youngskylty/SensoSpoon/EXPLANATION/08_GENERATED_OUTPUTS.md

# Generated Outputs (`output/`, `assets/geometry/`)

Everything in this document is **regenerated by scripts** — none of it is source content you'd hand-edit. Everything here was inferred from reading the scripts that produce each file; I did not visually inspect the images/videos themselves (I can't view rendered pixel content directly in this pass), so descriptions are of *what the generating code computes and draws*, not a frame-by-frame visual description.

## `output/figures/` — images and videos

| File | Produced by | What it shows |
|---|---|---|
| `rcflex_assembled.png` | `preview_rcflex_design('assembled')` | Full 3D assembly, all parts opaque: outer shell, spherical bezel, control panel, everything visible as the product would look externally. |
| `rcflex_cutaway.png` | `preview_rcflex_design('cutaway')` | Same assembly with the outer shell, bezel, moving carrier's outer surface, control panel, and buttons/LEDs hidden — revealing the internal flexures, actuators, pushrods, and PCB/battery. |
| `spoon_curved_neck_closeup.png` | `preview_spoon_closeup.m` | A tight camera crop on just the bowl, neck, spherical carrier, and quick-release collar. |
| `spoon_dimension_verification.png` | `preview_spoon_dimensions.m` | A 2D dimensioned-drawing-style figure (top view, longitudinal section, cross-section) with dimension lines confirming the 62×40×12 mm bowl and wall-thickness values against the analytic outline function. |
| `rcflex_voltage_response.png` | `plot_rcflex_plant.m`, called from `run_rcflex_analytic('voltage',...)` | 6-panel plot of an open-loop voltage test: applied voltage, solved current, solved joint angle, actuator displacement, force, copper loss, over the default common/differential voltage step sequence. |
| `voltage_test.mp4` | `animate_rcflex_analytic(S, ..., 'assembled')`, called from `START_PROJECT('simulate')` / `START_PROJECT('all')` | 3D animation of the assembled spoon responding to the same open-loop voltage step sequence — pure electromechanical response, no control algorithm. |
| `rcflex_physical_test.png` | Final frame export from `animate_rcflex_analytic.m` when `S.mode` is not `'closed_loop'` | A single still frame from the voltage-test animation. |
| `control_response.png` | `plot_rcflex_control.m` | 6-panel closed-loop response plot for one run: pitch/roll error vs. locked-baseline error, coil currents (with current-limit reference lines), actuator stroke (with stroke-limit lines), bowl position error, and copper loss (with continuous-power reference line). Title includes attitude RMS, suppression %, and position RMS for that run. |
| `control_demo.mp4` | `animate_rcflex_analytic(S,...,'assembled')`, called from `START_PROJECT('control')` | 3D animation of the assembled spoon under closed-loop control, for a native-Simulink control run. |
| `rcflex_control_animation.png` | Final-frame export from `animate_rcflex_analytic.m` when `S.mode == 'closed_loop'` | A still frame from the closed-loop control animation. |
| `control_comparison.mp4` / `.png` | `animate_rcflex_comparison.m`, called from `START_PROJECT('compare')` | Side-by-side "without compensation" (gimbal rigidly locked) vs. "with compensation" (closed-loop controlled) 3D animation, driven by identical base motion, with live pitch/roll error traces underneath. Two playback passes: real-time then quarter-speed. |
| `control_intent_response.png` | Referenced in project structure but not directly traced to a specific generating call in the read source files; based on naming and the "intent" scenario in `rcflex_control_case.m`, likely a response plot for an intent-tracking test case (case 10 in the benchmark set) — treat this description as inferred from naming, not directly confirmed against a specific script call. |
| `soup_5ml_comparison.mp4` / `.png` | `run_rcflex_soup_demo(5)` → `animate_rcflex_comparison(S, filename, F)` | Side-by-side comparison animation with an overlaid liquid surface: 5 mL soup, 8 Hz, 1°/axis tremor, uncompensated (locked) vs. compensated bowl, showing computed liquid slosh/level with neither side losing measurable liquid. |
| `soup_8ml_comparison.mp4` / `.png` | `run_rcflex_soup_demo(8)` | Same as above but 8 mL fill (near-full bowl capacity, ~9.1 mL) — the uncompensated side shows a very small computed spill (~0.0016 mL), compensated side shows none. |
| `soup_strong_tremor_comparison.mp4` / `.png` | `run_rcflex_strong_soup.m` | A more aggressive 4-second, 4 Hz, 5°/axis, 8 mL scenario — uncompensated side loses roughly a third of its liquid (~2.7 mL, ~34%) while the compensated side loses none computed. Plays first at real-time, then quarter-speed. |
| `tremor_hardware_envelope.png` | `evaluate_rcflex_envelope.m` | Two-panel figure: required peak current vs. tremor frequency (for two payload levels) compared against the actuator's current limit, assuming *ideal* attitude tracking (inverse-dynamics feasibility, not an actual controller run); and a bar chart comparing bowl position RMS for a locked spoon vs. ideal attitude tracking, illustrating that leveling the bowl doesn't stop it translating. |

## `output/results/` — data and reports

| File | Produced by | Content |
|---|---|---|
| `analytic_validation.txt` | `test_rcflex_physics.m` | A JSON-formatted record of the physics test's measured tolerances: rod closure error, Jacobian error, energy-balance error, solver-convergence difference, max transmission-Jacobian condition number, max direct-rod side load — from the last time the test ran. |
| `analytic_hardware_validation.csv` | `test_rcflex_hardware.m` | A one-row table: locked-rotor RL step error, reversed-polarity error, and payload-response-difference magnitude from the last hardware acceptance test run. |
| `validation_summary.csv` | `run_validation.m` | Pass/fail and elapsed time for all eleven checks in the validation suite (see `07_TESTS.md`). |
| `control_training.csv` | `tune_rcflex_control.m` | Small grid-search results (lowpass filter cutoff × attitude bandwidth) against per-frequency tremor RMS and an intent-tracking error — an early design-exploration record, not the final selected design (which uses the notch filter instead). |
| `control_benchmark.csv` | `benchmark_rcflex_control.m` | The 20-scenario held-out benchmark table: per-case scenario name, frequency, amplitude, payload, bus voltage, and every metric from `rcflex_control_metrics.m` (attitude RMS, suppression %, position RMS, currents, stroke, power, side load, whether it stayed within hardware limits). |
| `control_case_01.mat` … `control_case_20.mat` | `benchmark_rcflex_control.m` | Full saved simulation result (`S`) and metrics (`m`) for each of the 20 benchmark cases individually. |
| `control_numerical_verification.csv` / `.mat` | `verify_rcflex_control_numerics.m` | Cross-check of the fast multirate control integrator against native Simulink at three mechanical step sizes — joint-angle RMS/peak differences and suppression-percentage differences. |
| `control_native.mat` | `run_rcflex_control.m` (default call) | The saved native-Simulink closed-loop reference run (8 Hz, 1°/axis, default 5 g payload) used as the authoritative reference elsewhere (e.g. by `verify_rcflex_control_numerics.m` and `write_rcflex_control_report.m`). |
| `control_initial.mat` | Likely an earlier/first native control run snapshot (naming suggests a first-pass saved result; not directly traced to a currently-active call in the read scripts). |
| `CONTROL_RESULTS.md` | `write_rcflex_control_report.m` | Human-readable markdown report: the 20-case benchmark table, notes on what each special case tests, the fast-vs-native cross-check numbers, and the native-reference headline numbers. This is the single most important results document for judging current controller performance — see `03_CONTROL_SYSTEM.md` for the numbers themselves. |
| `liquid_5ml.mat`, `liquid_near_full.mat`, `liquid_comparison.mat` | `run_rcflex_soup_demo.m` / `simulate_rcflex_liquid.m` (`saveResult=true` path) | Saved fluid-simulation structs (`F`) for specific fill volumes, paired with the mechanical result `S` they were computed from. |
| `liquid_refinement.csv` | Referenced in `docs/LIQUID_MODEL.md` as the grid/step-refinement sensitivity check for the 8 mL case (halved grid spacing and time step). |
| `strong_soup_native.mat` | `run_rcflex_strong_soup.m` | Saved mechanical (`S`), fluid (`F`), and metrics (`m`) for the 4 Hz/5°/8 mL strong-tremor scenario. |
| `strong_soup_refinement.mat` / `.csv` | `run_rcflex_strong_soup.m` | A refined-grid re-run of the strong-tremor fluid case (half grid spacing, half time step) compared against the original, for both "without spill tracking" and "with spill tracking" totals. |
| `strong_soup_screen.csv`, `strong_soup_screen_3deg.mat` / `_4deg.mat` / `_5deg.mat` | `screen_rcflex_strong_soup.m` | A fast-integrator screening sweep over 3/4/5° amplitude at the strong-tremor scenario, checking hardware limits and computing spill before committing to the (slower) native-Simulink strong case. |
| `tremor_hardware_envelope.csv` | `evaluate_rcflex_envelope.m` | The full feasibility table behind the `tremor_hardware_envelope.png` figure — one row per payload/frequency/amplitude combination, with required current/voltage/power/side-load/stroke and a `nominal_feasible` flag. |
| `tremor_robustness.csv` | `evaluate_rcflex_robustness.m` | The same envelope table computed twice — once nominal, once with several hardware parameters deliberately worsened — concatenated with a `scenario` column. |
| `notch_frequency_trial.csv` | Naming suggests an exploratory trial of notch-filter frequency placement (part of arriving at the final 4/6/8/10/12 Hz notch design); not directly traced to an active generating call among the read scripts — likely from an earlier tuning pass. |
| `cleanup_baseline.mat`, `cleanup_regression.txt`, `analysis_run.txt` | Records from the project reorganization described in `docs/CLEANUP.md` — a saved pre-cleanup baseline and a regression-comparison log confirming the reorganized code reproduces identical results; not something you need to regenerate or rely on for ongoing work. |

## `assets/geometry/` — 3D geometry

- **`assembly.mat`** — the master saved data: the full parts struct array `A` (name, body, category, color, mass, mesh vertices/faces, STL filename) plus the hardware parameter struct `H` used to generate it. Nearly everything downstream that needs 3D geometry (animators, previews, body-property calculations, the liquid-geometry bowl profile) loads this one file rather than regenerating meshes each time.
- **`parts_manifest.csv`** — a flat table of every part's name, rigid body group, category, and mass in grams — a quick way to see the full parts list and their masses without loading the `.mat` file.
- **One `.stl` file per part** (e.g. `Spoon_bowl.stl`, `VCA_A_winding.stl`, `Cflex_B10_fixed_1.stl`, etc.) — standard binary STL triangle meshes, in metres, one per named part in the assembly, generated by the hand-written `write_stl` helper inside `generate_rcflex_assets.m`. These could in principle be opened in any CAD viewer to inspect the geometry directly.

All of the above regenerate automatically: `START_PROJECT` rebuilds `assembly.mat` (and thus every STL) whenever the current `rcflex_parameters()` struct doesn't match the one cached inside the existing `assembly.mat` — you do not need to run the geometry generator by hand unless you're calling its lower-level functions directly.
