youngskylty/SensoSpoon/EXPLANATION/SensoSpoon Simulation Architecture.png

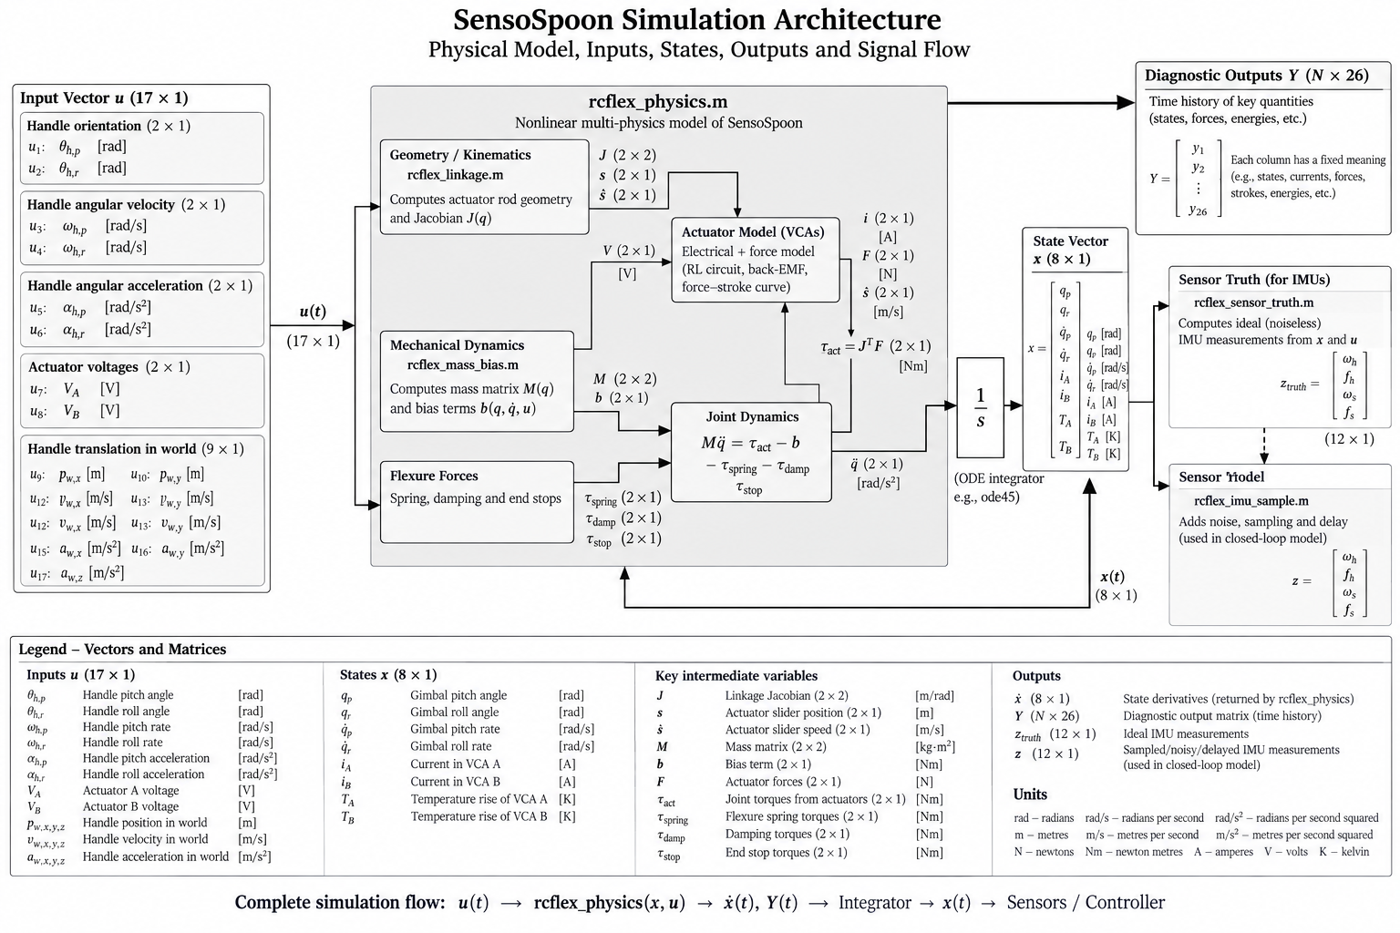
EXPLANATION/SensoSpoon Simulation Architecture.png
