youngskylty/SensoSpoon/output/figures/bench_attitude_error.png

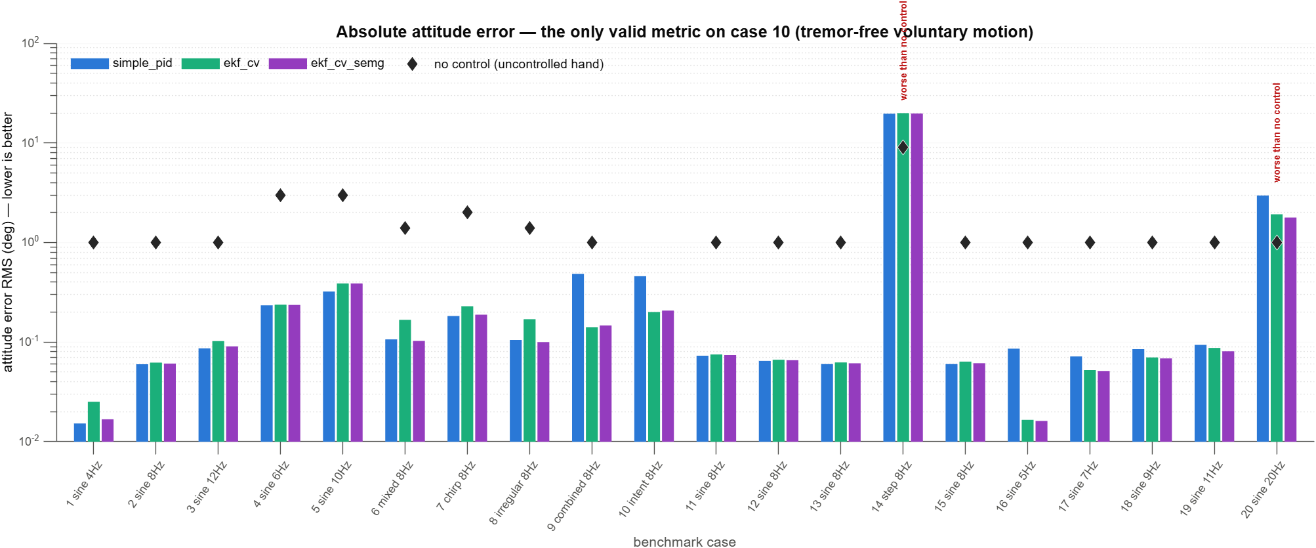
output/figures/bench_attitude_error.png
