youngskylty/SensoSpoon/output/figures/bench_delta_vs_baseline.png

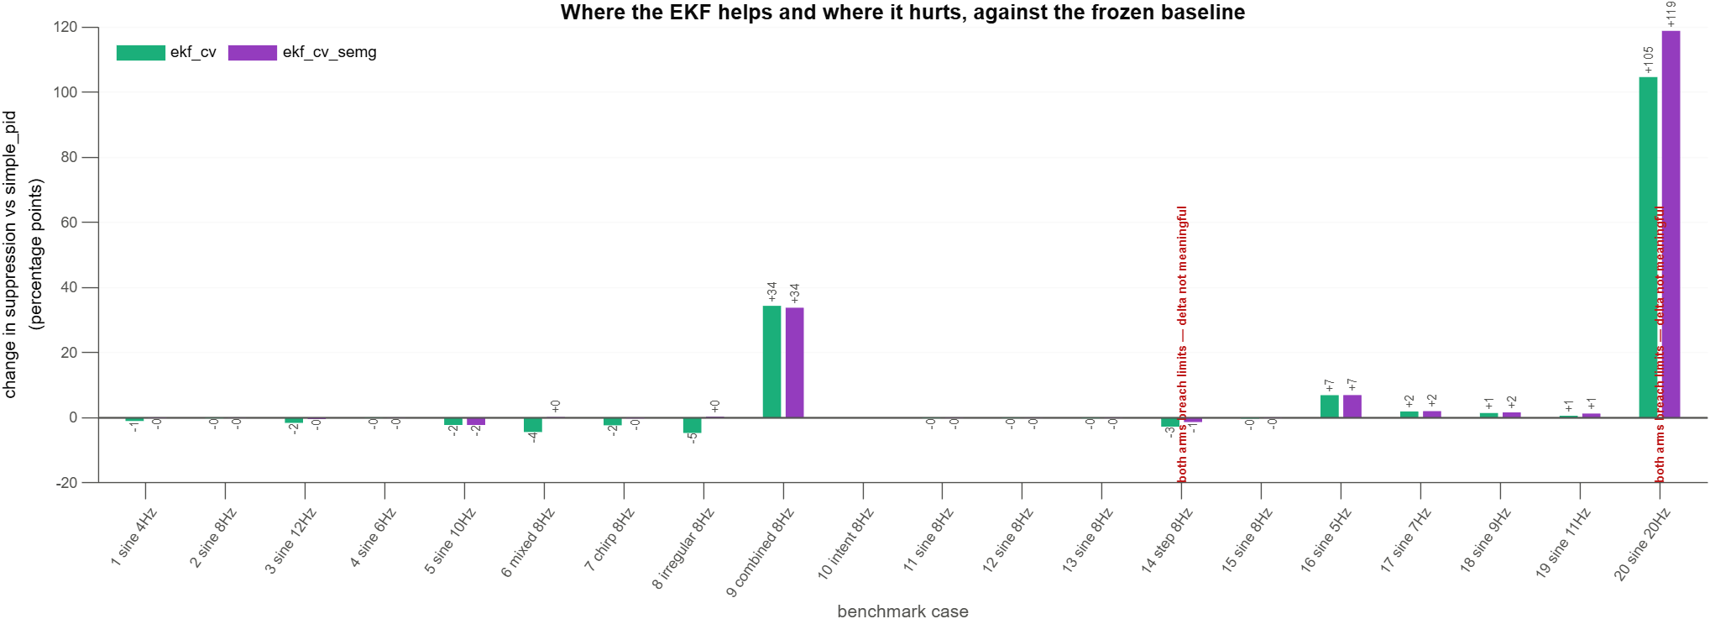
output/figures/bench_delta_vs_baseline.png
