youngskylty/SensoSpoon/output/figures/bench_suppression.png

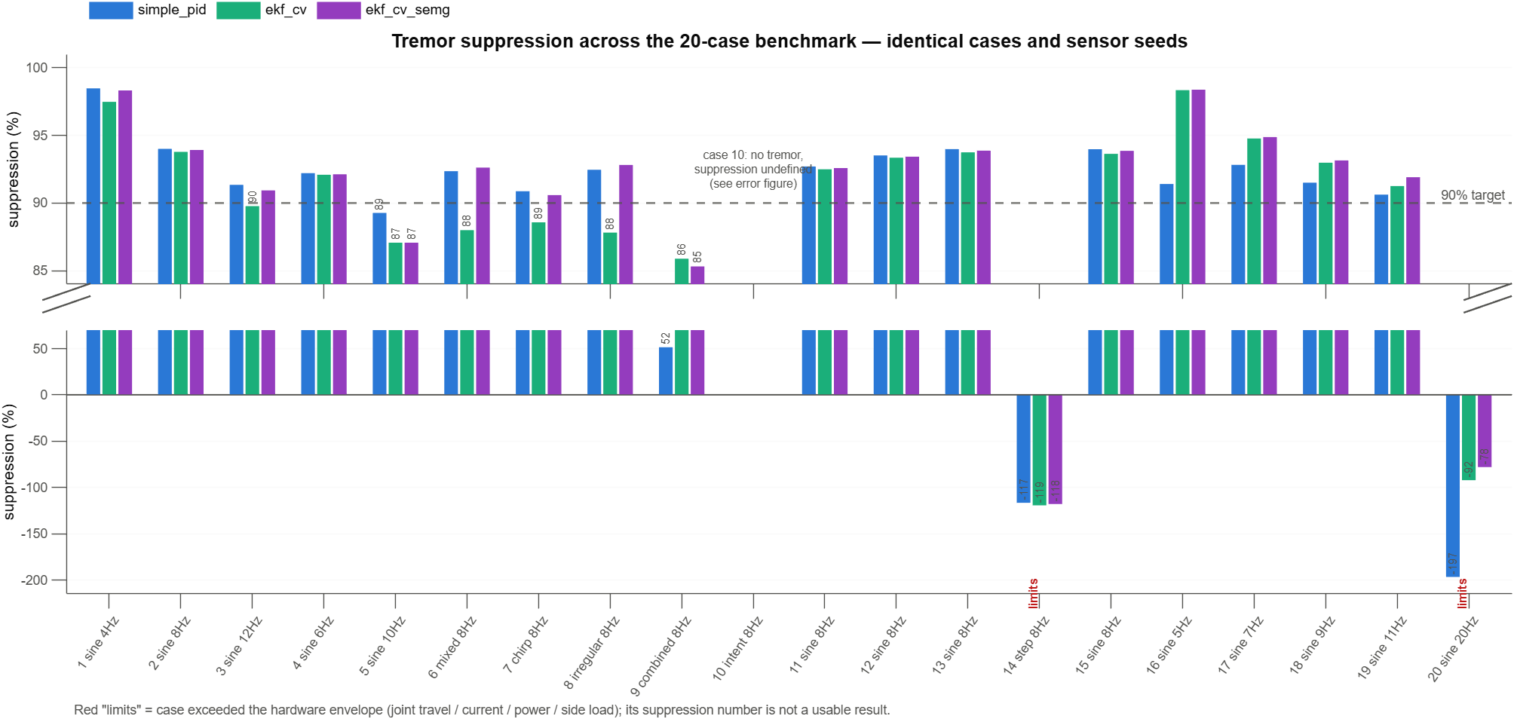
output/figures/bench_suppression.png
