youngskylty/SensoSpoon/output/figures/control_comparison.png

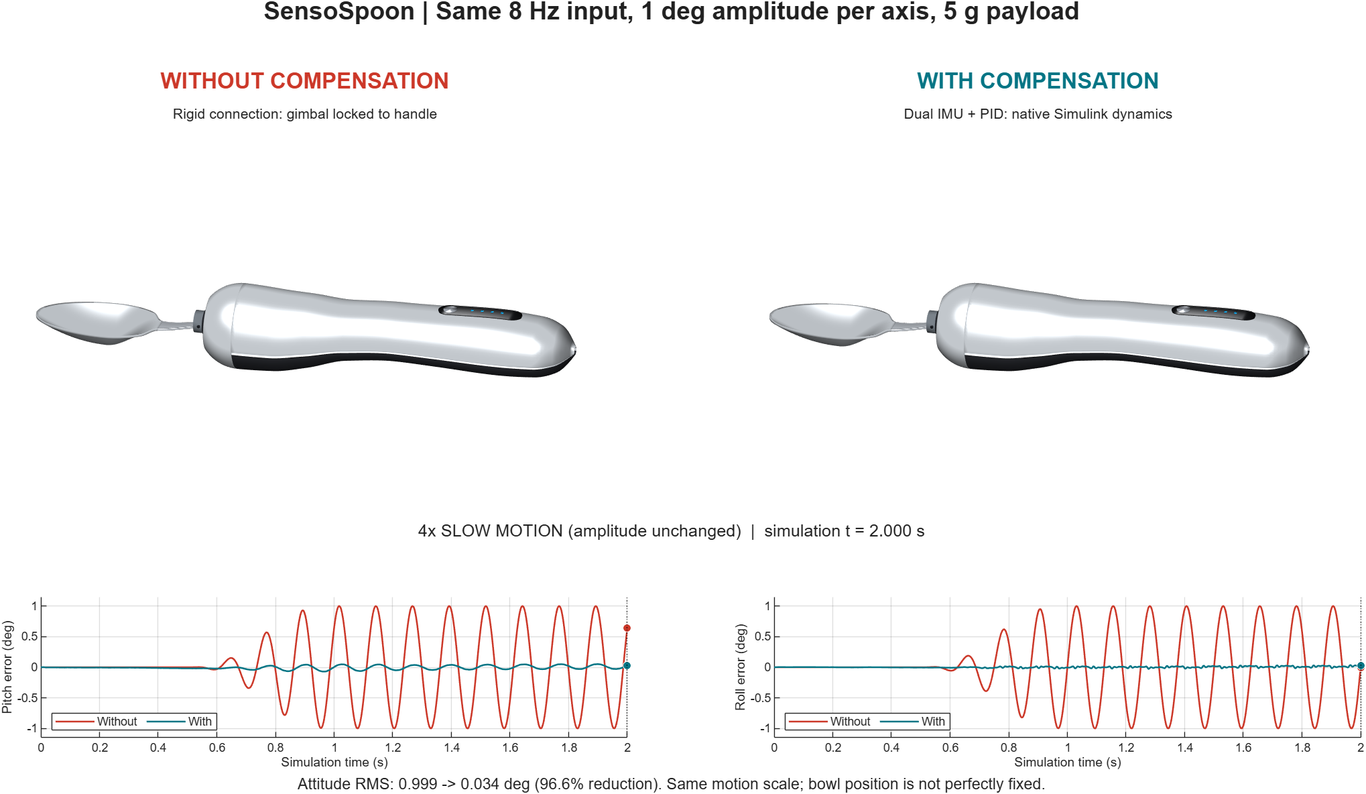
output/figures/control_comparison.png
