youngskylty/SensoSpoon/output/figures/control_intent_response.png

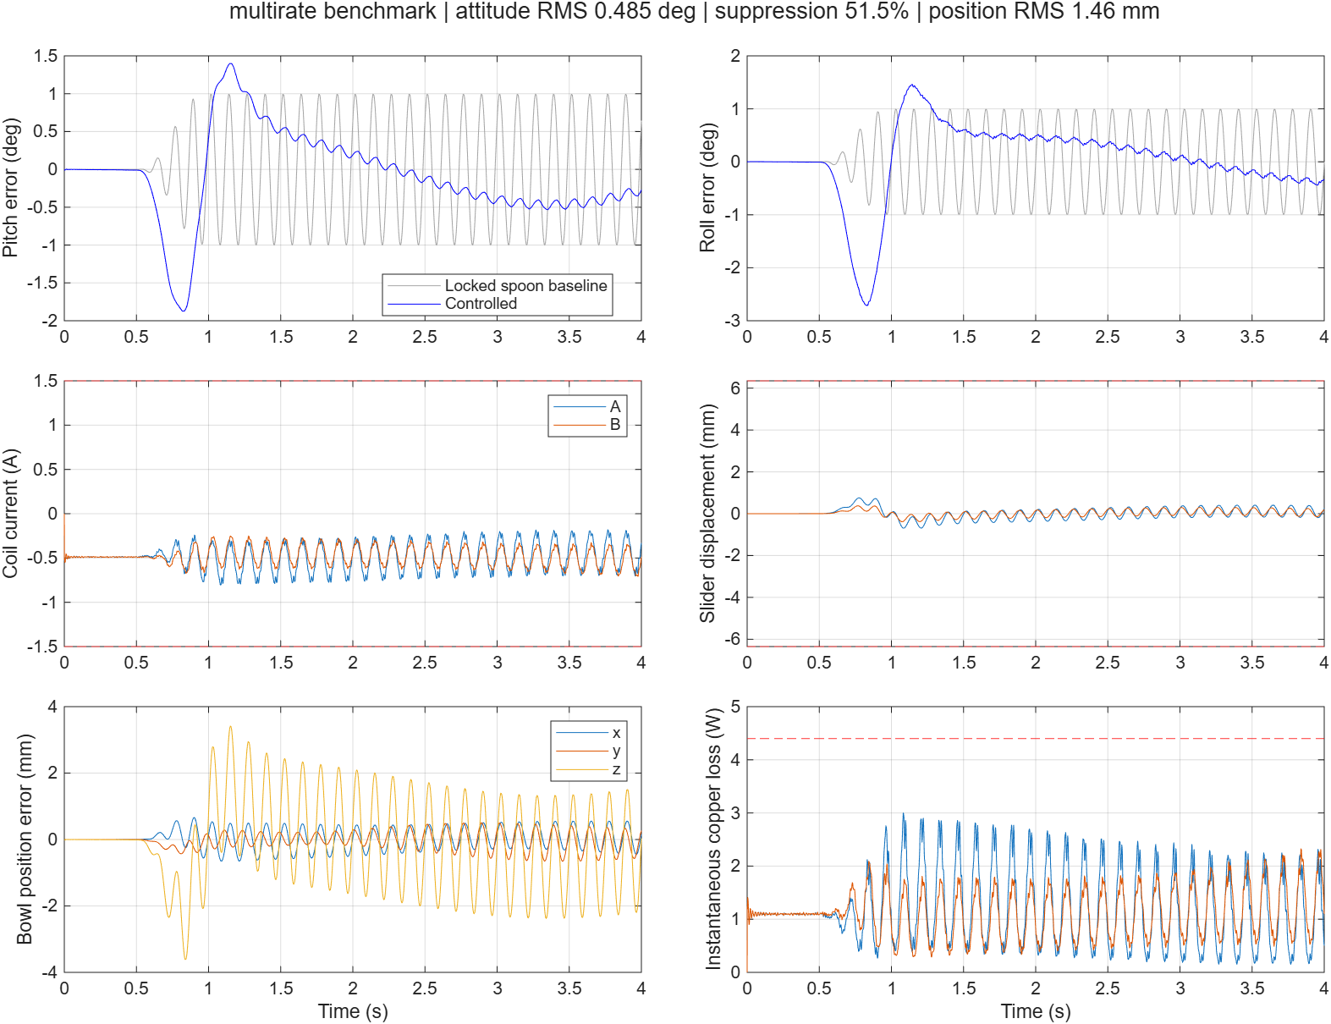
output/figures/control_intent_response.png
