youngskylty/SensoSpoon/output/figures/control_response.png

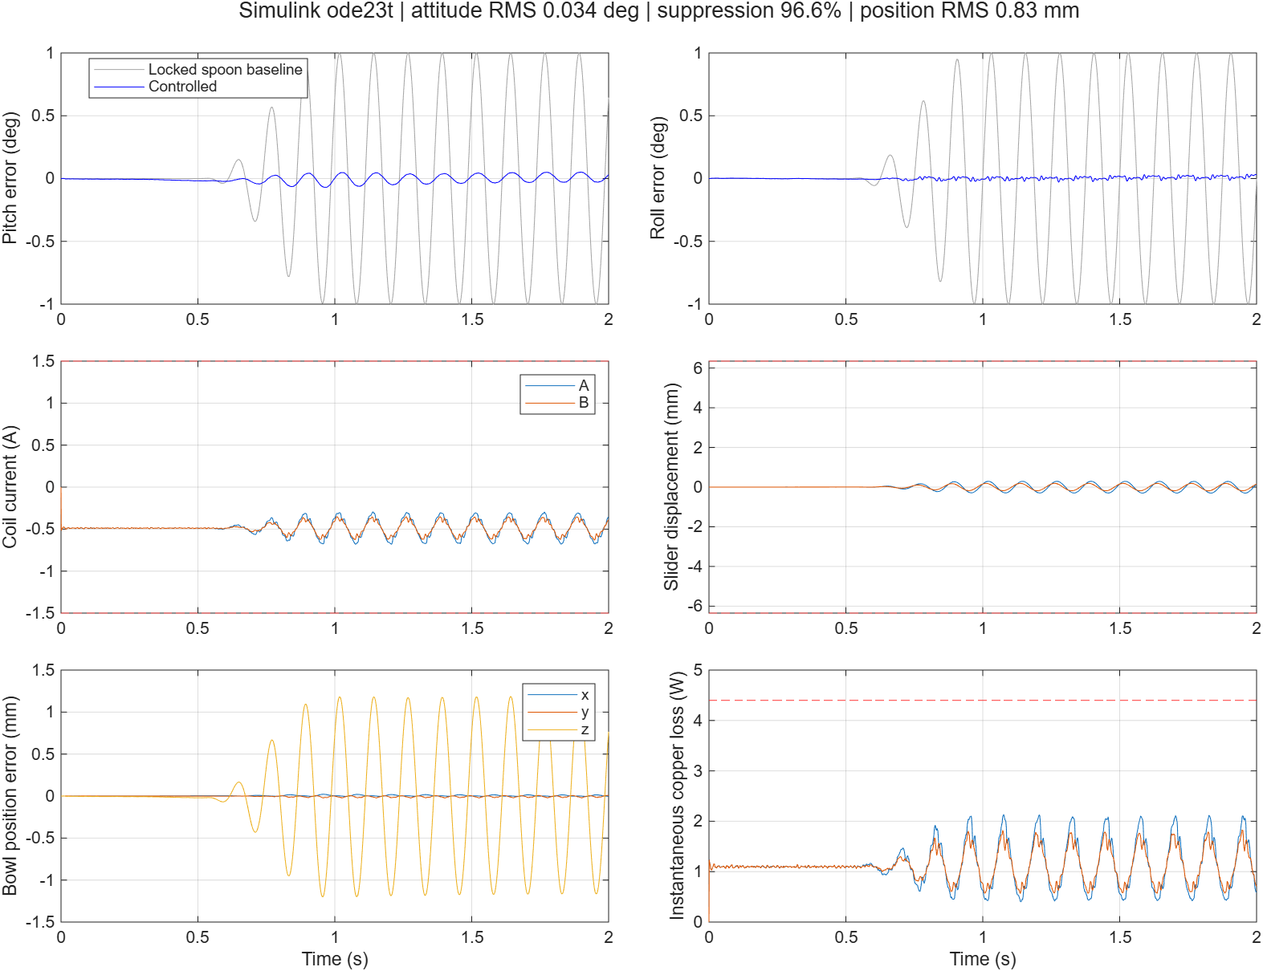
output/figures/control_response.png
