youngskylty/SensoSpoon/output/figures/fast_movement_detectors.png

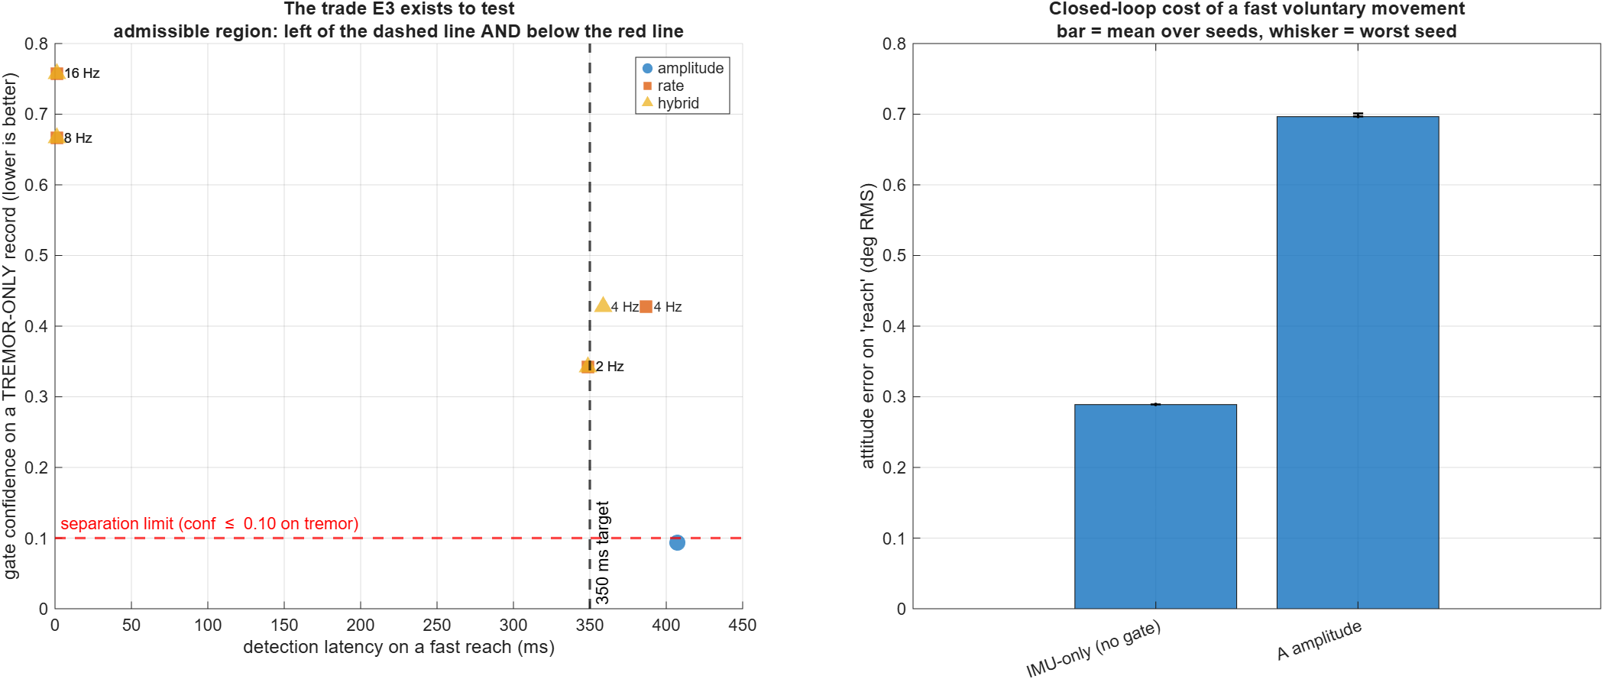
output/figures/fast_movement_detectors.png
