youngskylty/SensoSpoon/output/figures/intent_absorption_vs_frequency.png

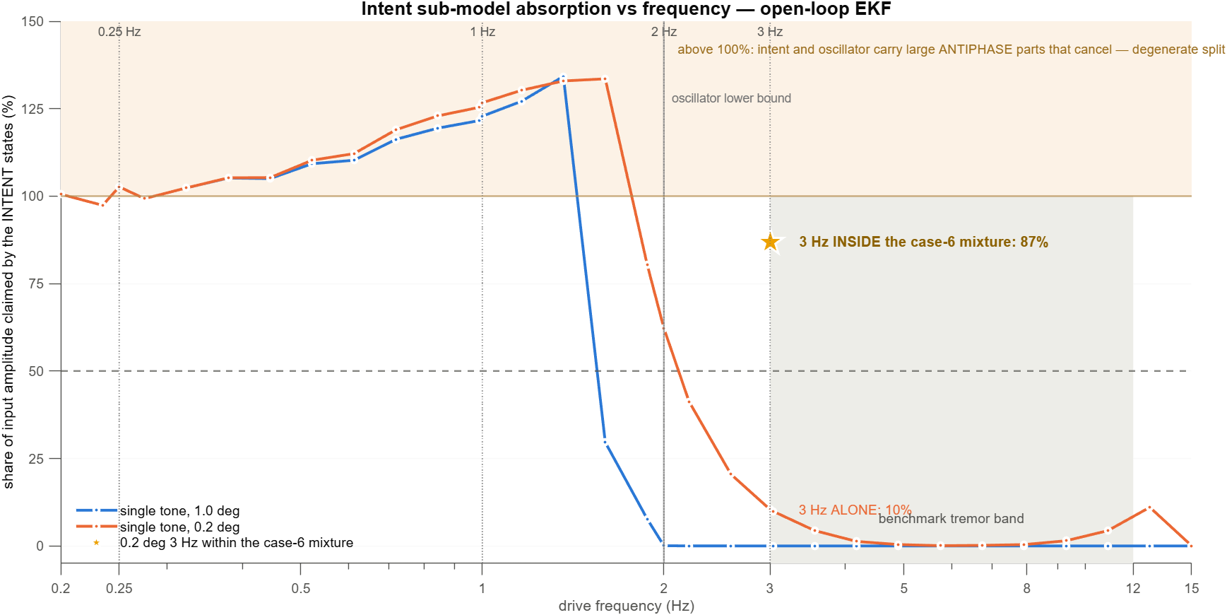
output/figures/intent_absorption_vs_frequency.png
