youngskylty/SensoSpoon/output/figures/intent_authority_ceiling.png

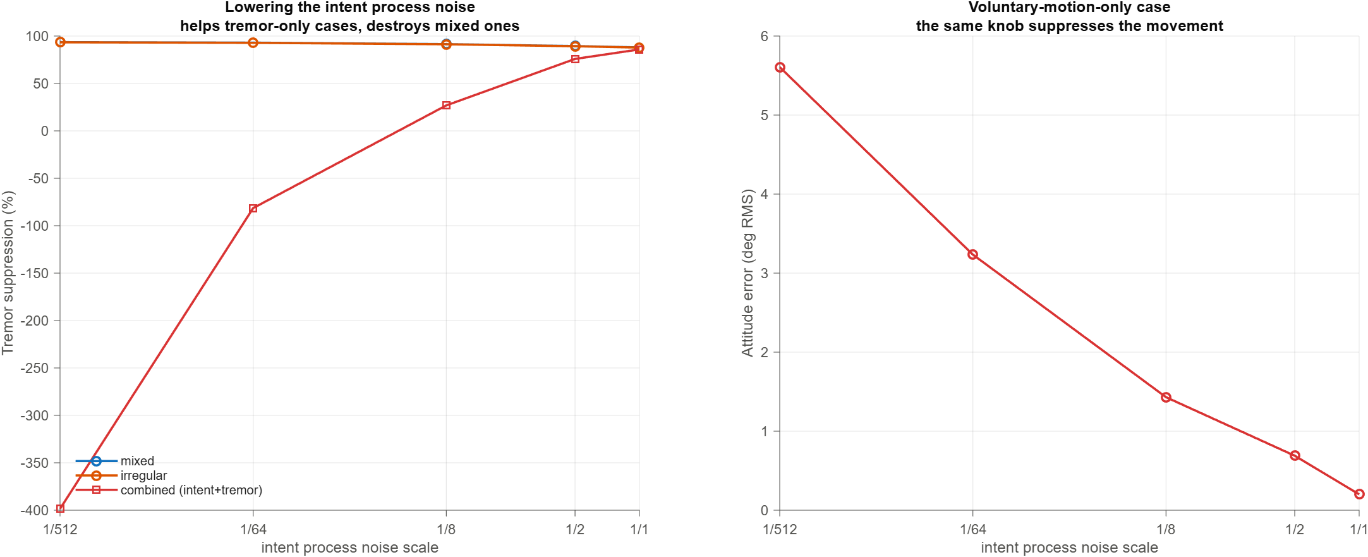
output/figures/intent_authority_ceiling.png
