youngskylty/SensoSpoon/output/figures/joint_travel_authority.png

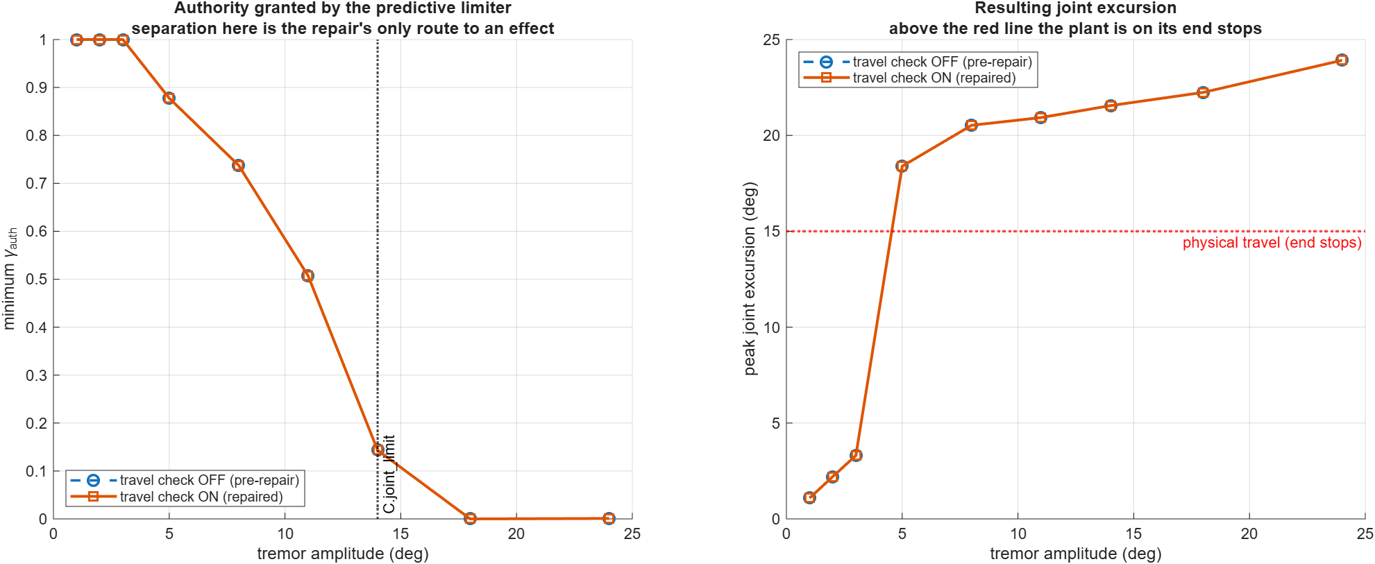
output/figures/joint_travel_authority.png
