youngskylty/SensoSpoon/output/figures/rcflex_control_animation.png

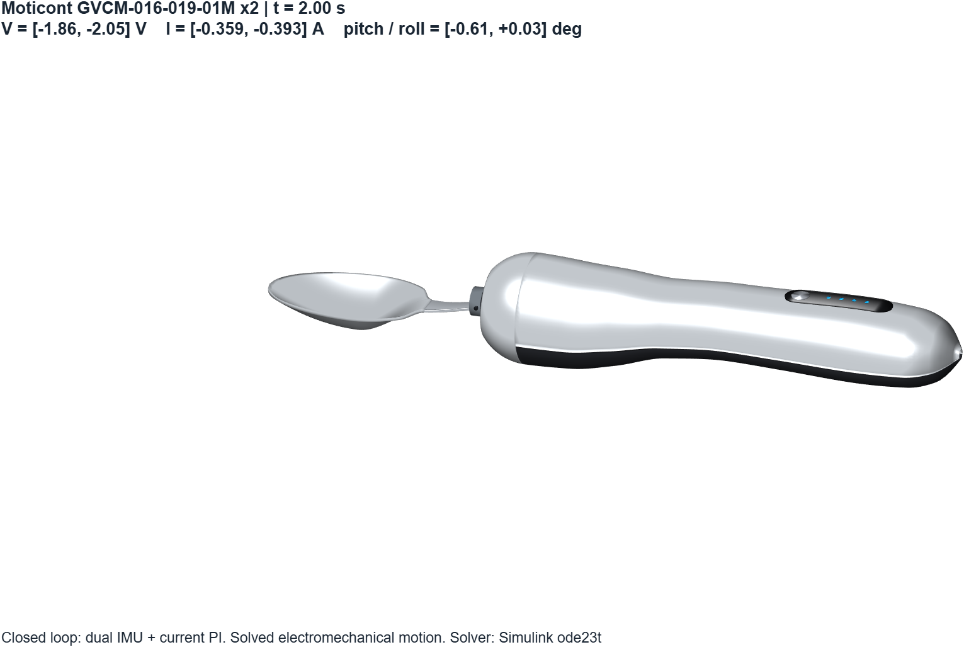
output/figures/rcflex_control_animation.png
