youngskylty/SensoSpoon/output/figures/rcflex_cutaway.png

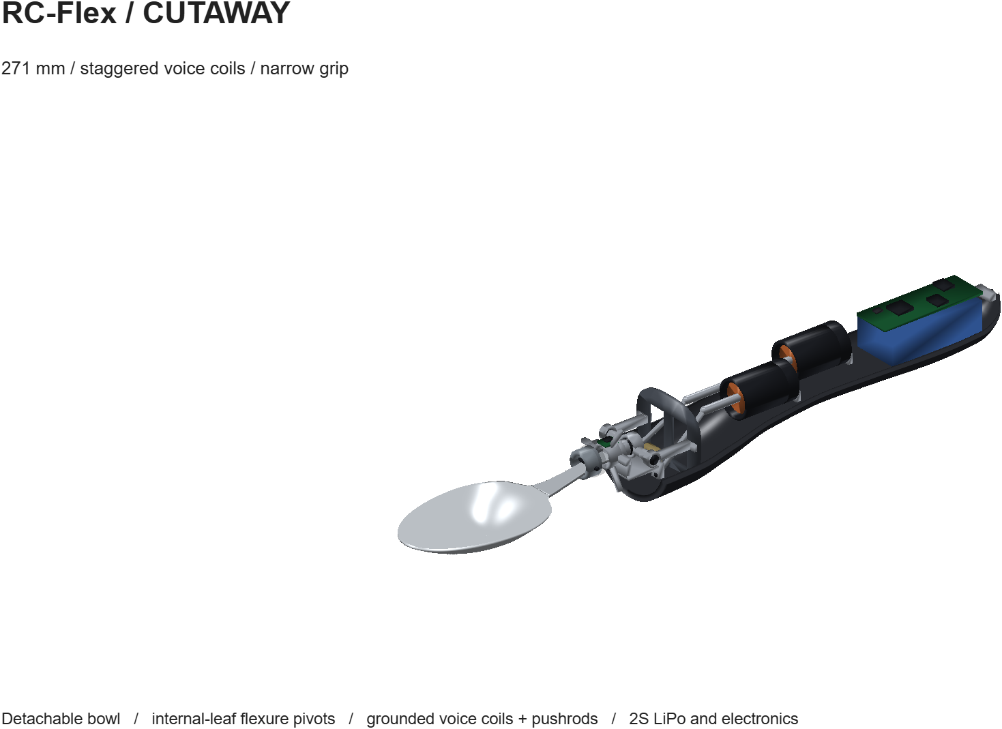
output/figures/rcflex_cutaway.png
