youngskylty/SensoSpoon/output/figures/rcflex_voltage_response.png

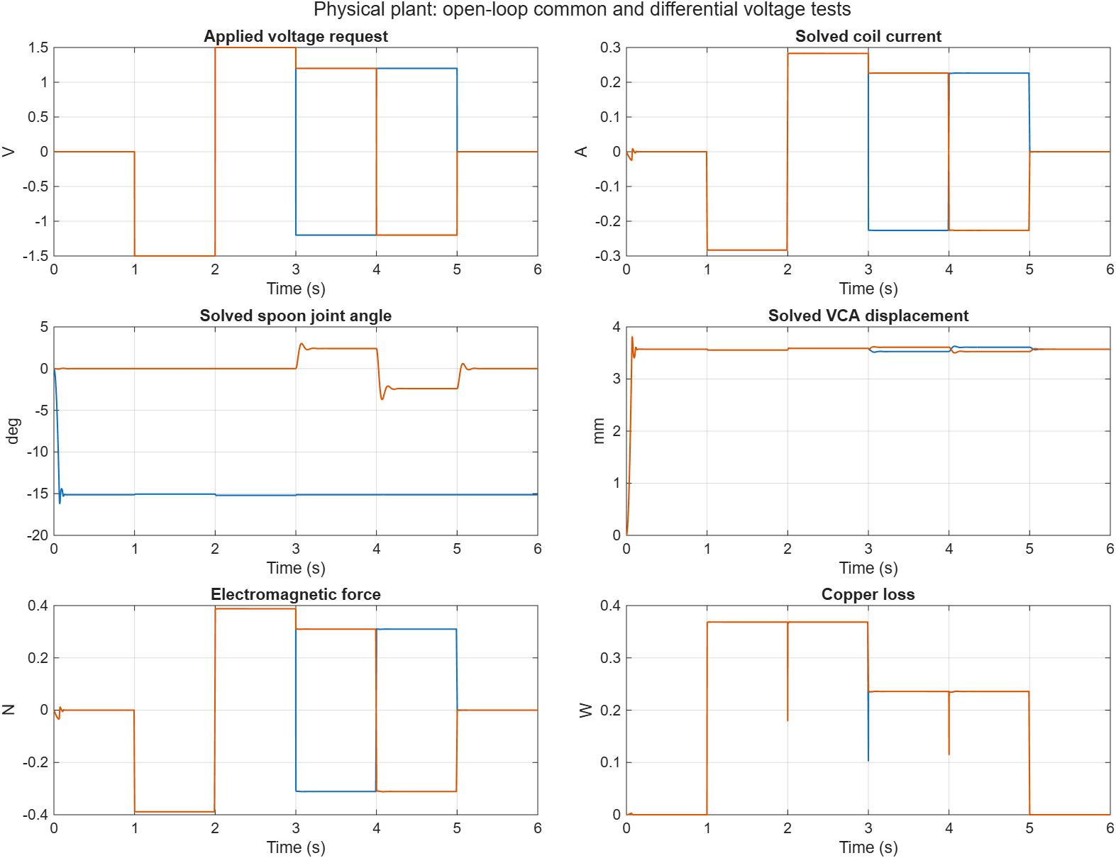
output/figures/rcflex_voltage_response.png
