youngskylty/SensoSpoon/output/figures/report/fig_reach_gate.png

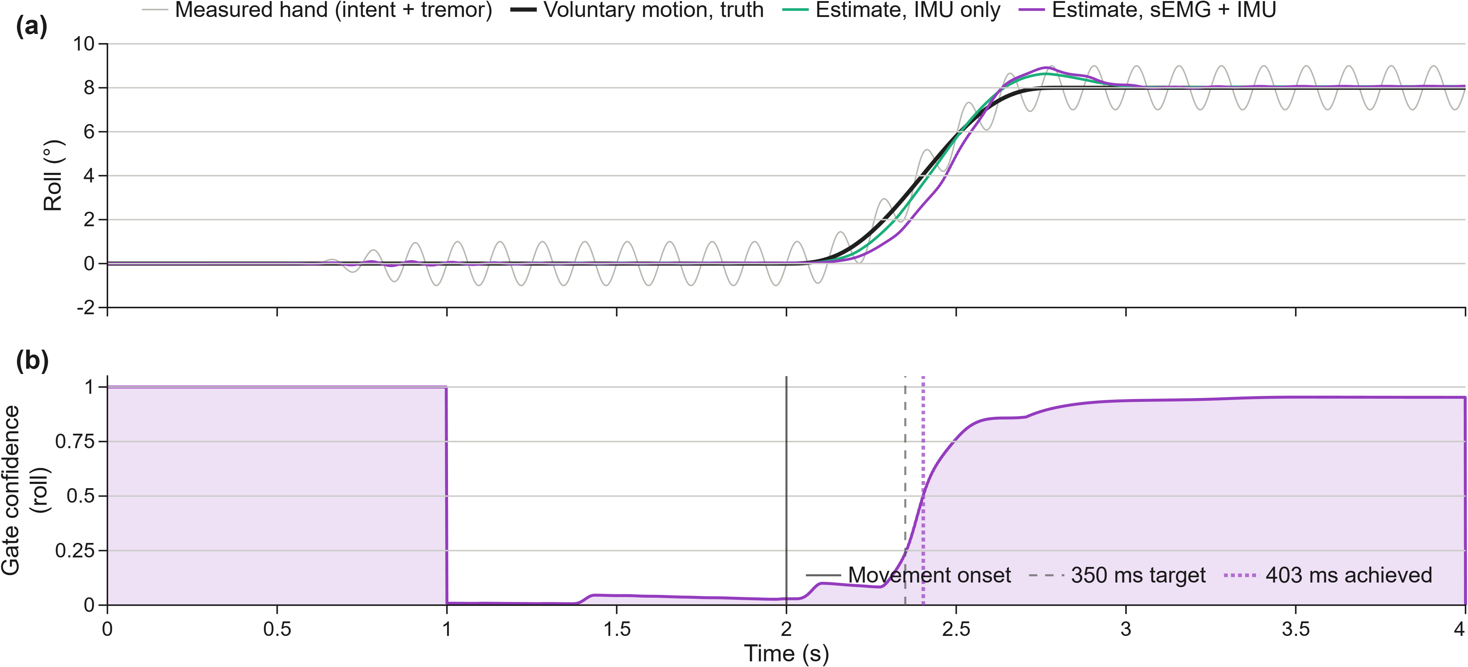
output/figures/report/fig_reach_gate.png
