youngskylty/SensoSpoon/output/figures/semg_gate_reach.png

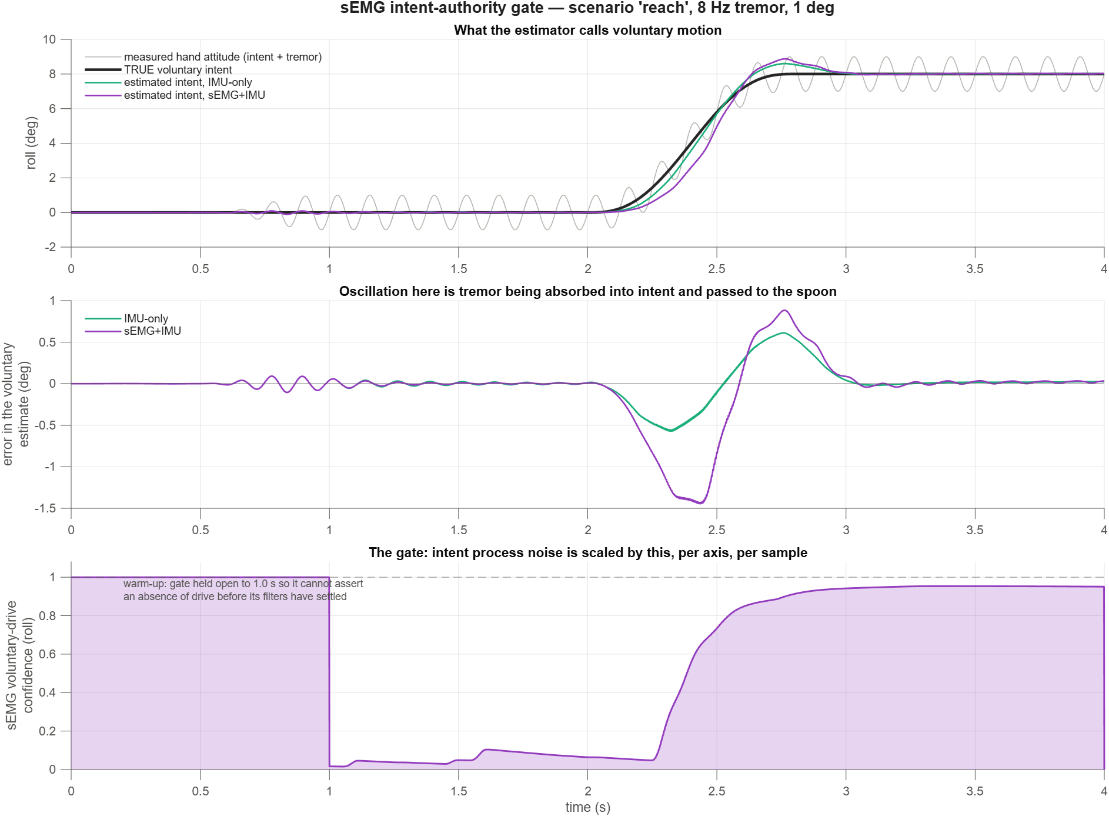
output/figures/semg_gate_reach.png
