youngskylty/SensoSpoon/output/figures/semg_intent_separation.png

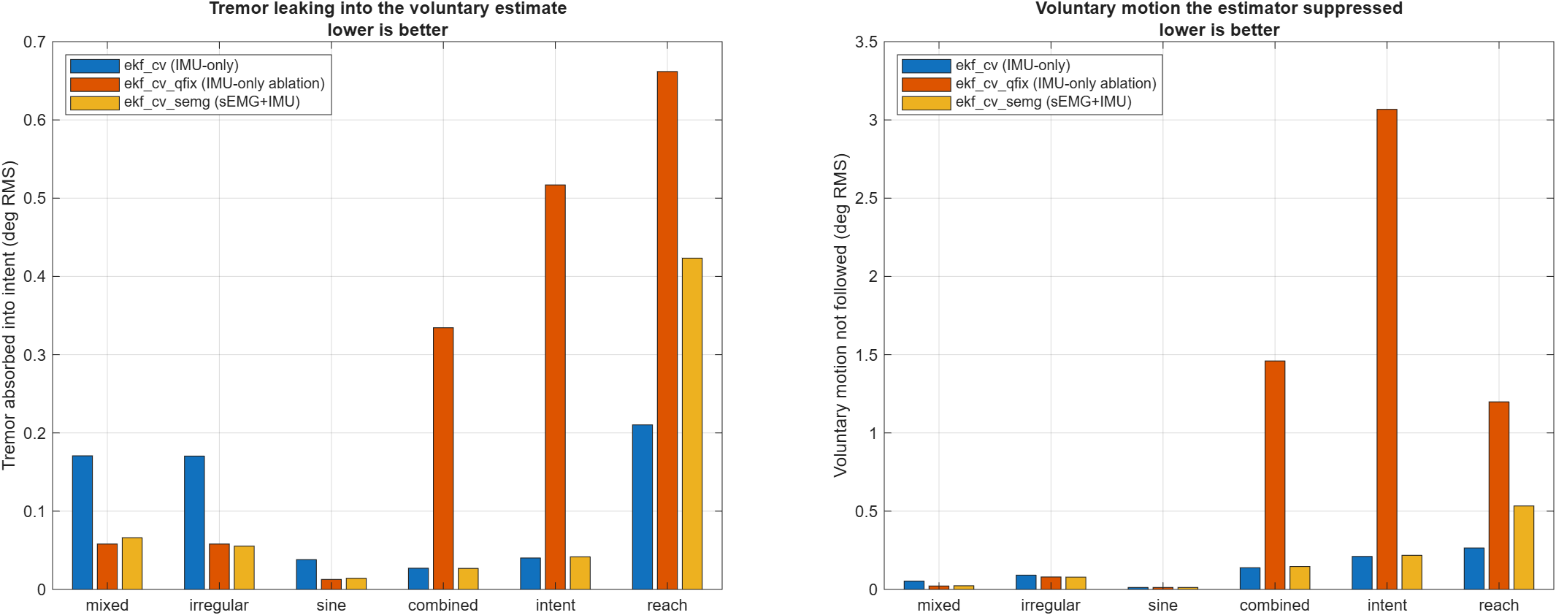
output/figures/semg_intent_separation.png
