youngskylty/SensoSpoon/output/figures/semg_separation_real.png

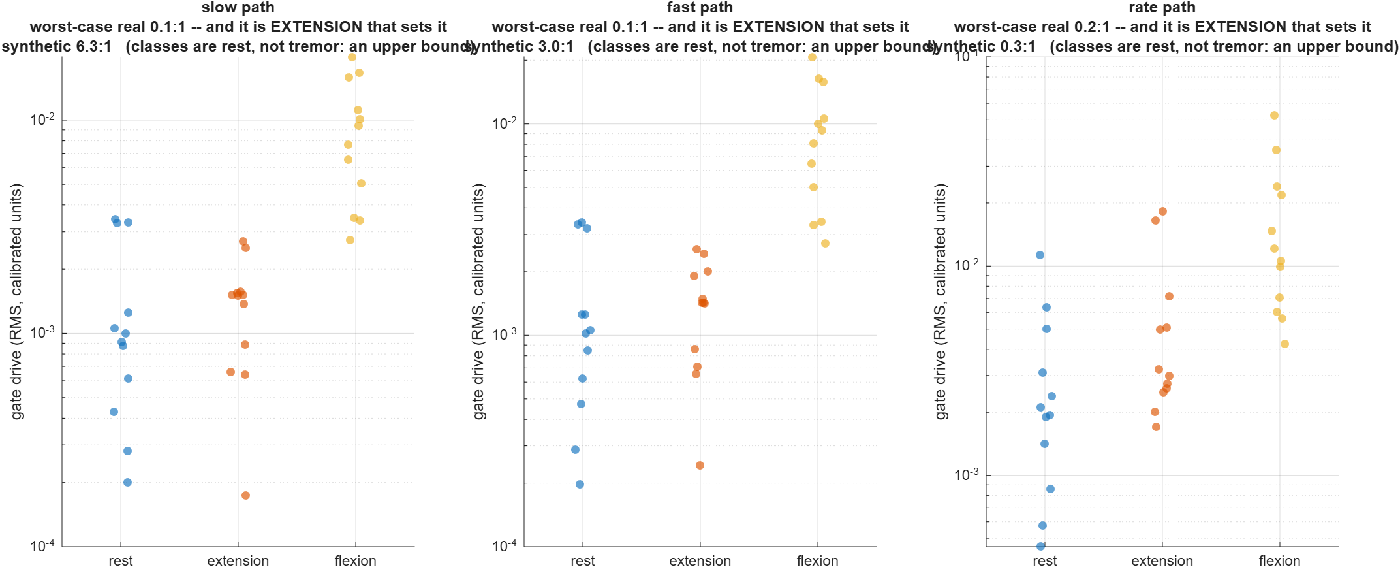
output/figures/semg_separation_real.png
