youngskylty/SensoSpoon/output/figures/soup_5ml_comparison.png

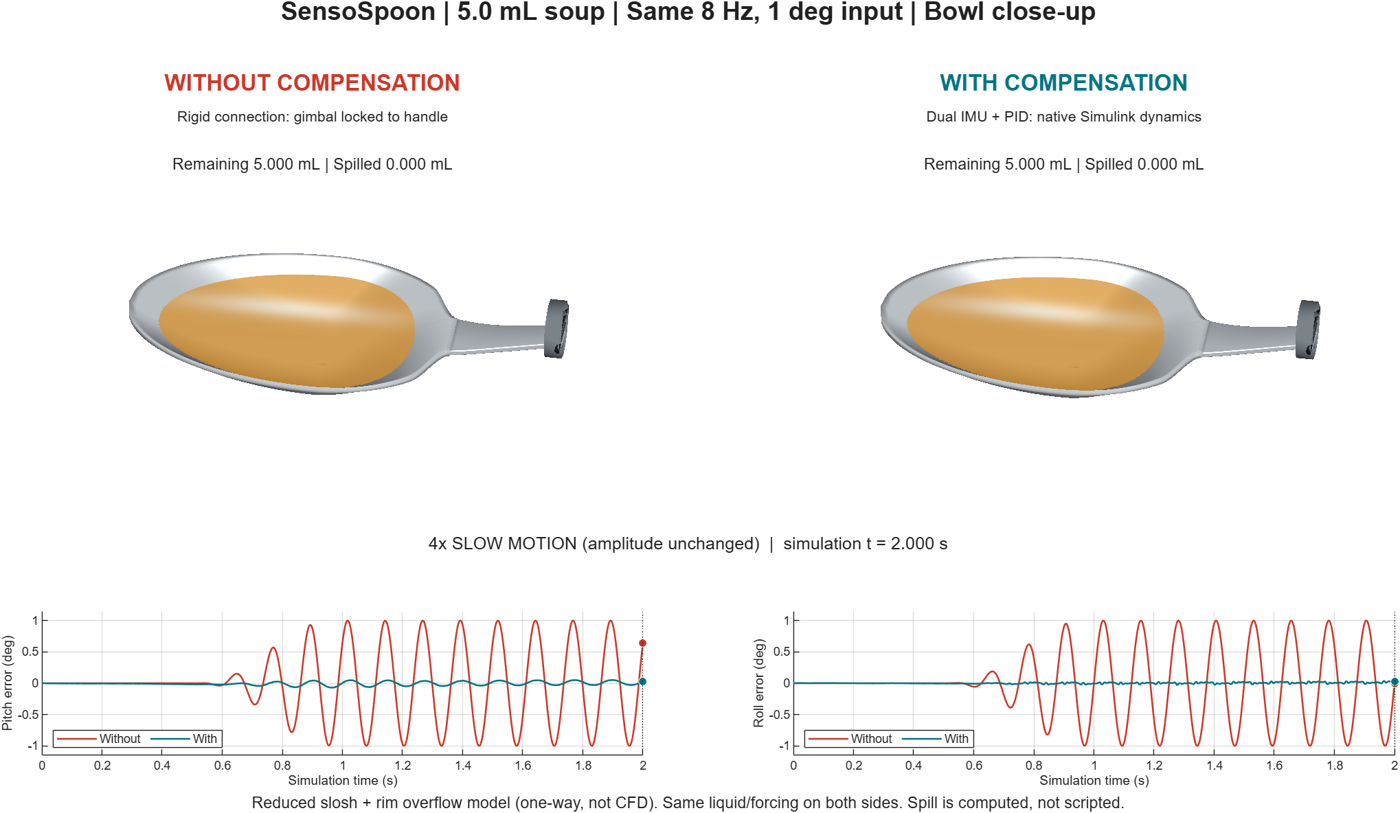
output/figures/soup_5ml_comparison.png
