youngskylty/SensoSpoon/output/figures/soup_strong_tremor_comparison.png

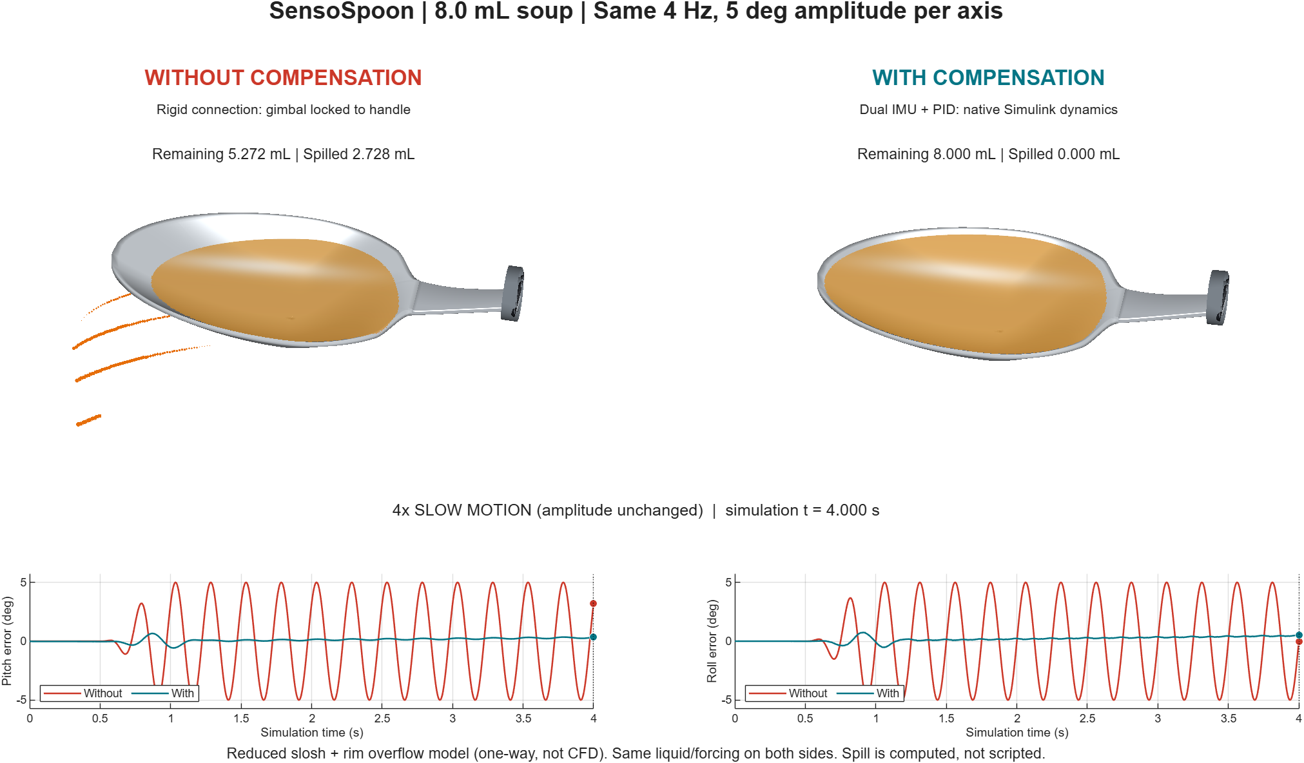
output/figures/soup_strong_tremor_comparison.png
