youngskylty/SensoSpoon/output/figures/spoon_curved_neck_closeup.png

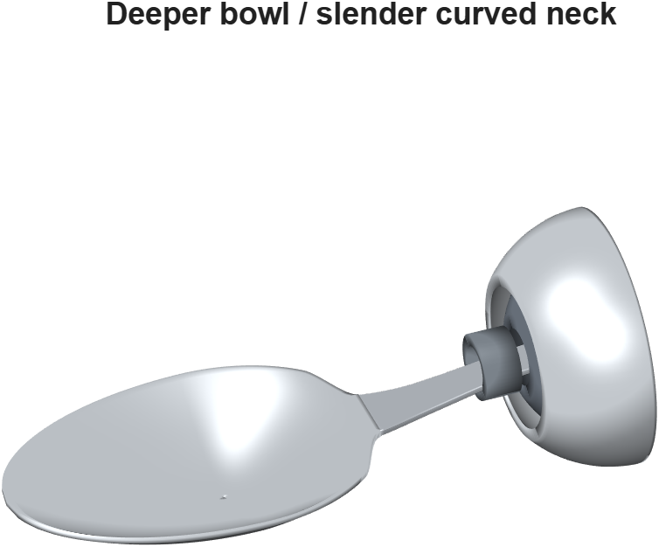
output/figures/spoon_curved_neck_closeup.png
