youngskylty/SensoSpoon/output/figures/tremor_hardware_envelope.png

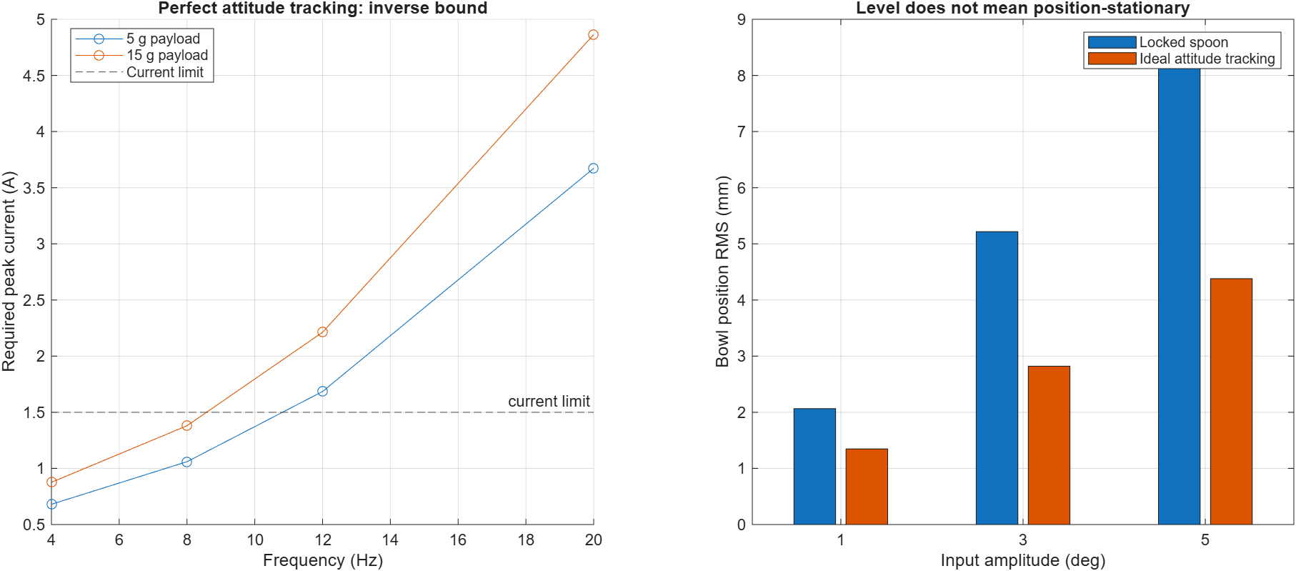
output/figures/tremor_hardware_envelope.png
