youngskylty/SensoSpoon/output/documents/SensoSpoon_Cost_and_Retail_Price_Analysis.docx

# SensoSpoon Cost and Retail Price Analysis

New Zealand market | 20 September 2026

Recommended launch price: NZ$699 including GST, with a regular price of NZ$799. The complete set includes the stabilising spoon, detachable spoon head, two-channel EMG cuff, charging accessories and carry case.

# Target production cost

The following targets assume approximately 1,000 units and production-ready components. They are planning estimates, not supplier quotations. All costs are NZD per set, excluding GST.

Item | Target cost
Two voice-coil actuators | $60
Gimbal, flexures, pushrods and connections | $35
Spoon electronics and assembled PCB | $40
Spoon battery, charging and protection | $15
Spoon head, housing and seals | $25
Complete two-channel EMG cuff | $60
Final assembly, calibration and testing | $35
Charging accessories, packaging and carry case | $12
Bulk freight and import handling allowance | $12
Total target landed cost | $294

Budget approximately NZ$300 per set delivered to a New Zealand warehouse. This requires lower-cost production sourcing; current industrial actuator and flexure prices are unconfirmed. Development, tooling and compliance testing are additional costs.

# Recommended retail prices

Package | Price including GST
Complete set - introductory price | NZ$699
Complete set - regular price | NZ$799
Spoon-only version - target price | NZ$549

A local benchmark is the Gyenno Bravo Twist, listed at NZ$790 including GST by MoveSmart and marked sold out when checked. Its accessories and functionality differ from SensoSpoon.

At NZ$699, revenue excluding 15% GST is approximately NZ$608. A NZ$300 landed cost leaves approximately NZ$308 gross profit per set (51%), before customer delivery, marketing, warranty, support and development expenses.

# Launch recommendation

Start with direct sales at NZ$699, subject to supplier quotes supporting a landed cost near NZ$300 and tests confirming useful EMG benefit. Keep a spoon-only option to lower the entry price. These prices remain targets until production costs and customer willingness to pay are validated.

Sources: MoveSmart product listing (https://movesmart.nz/products/gyenno-bravo-twist-spoon) | Inland Revenue GST guidance (https://www.ird.govt.nz/gst/charging-gst)
