youngskylty/SensoSpoon/assets/geometry/Coil_A_turn_09.stl

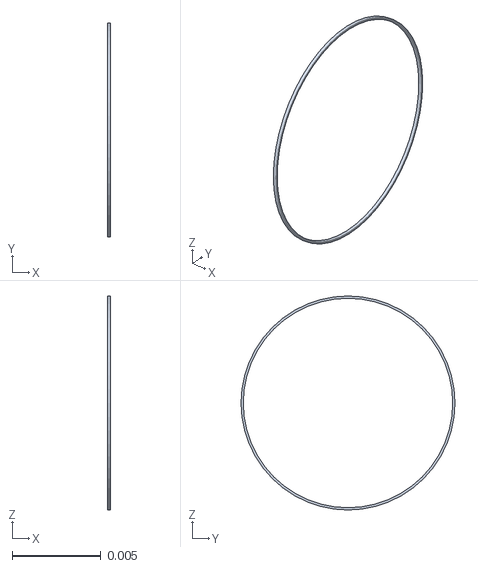
[picture p39: CAD file, 2026-09-11]
assets/geometry/Coil_A_turn_09.stl
0.00015 x 0.0121 x 0.0121
