youngskylty/SensoSpoon/assets/geometry/Roll_pivot_collet.stl

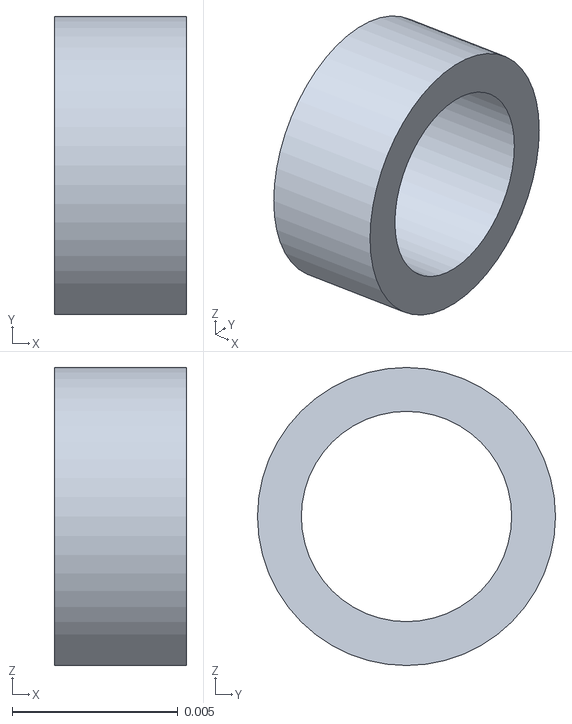
[picture p40: CAD file, 2026-09-11]
assets/geometry/Roll_pivot_collet.stl
0.004 x 0.009 x 0.009
