youngskylty/SensoSpoon/assets/geometry/Spoon_neck.stl

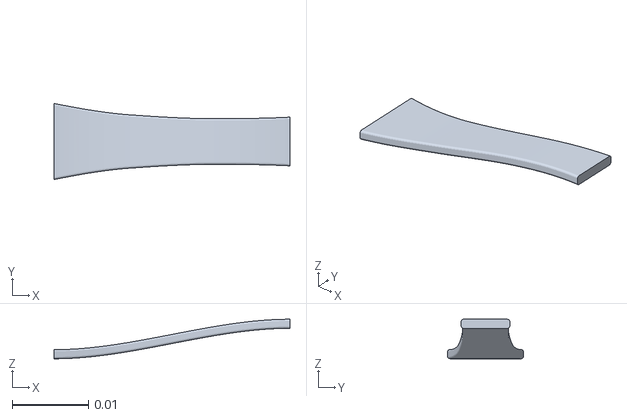
[picture p41: CAD file, 2026-09-11]
assets/geometry/Spoon_neck.stl
0.031 x 0.01 x 0.0052
