youngskylty/SensoSpoon/assets/geometry/Cheek_handle_root_3.stl

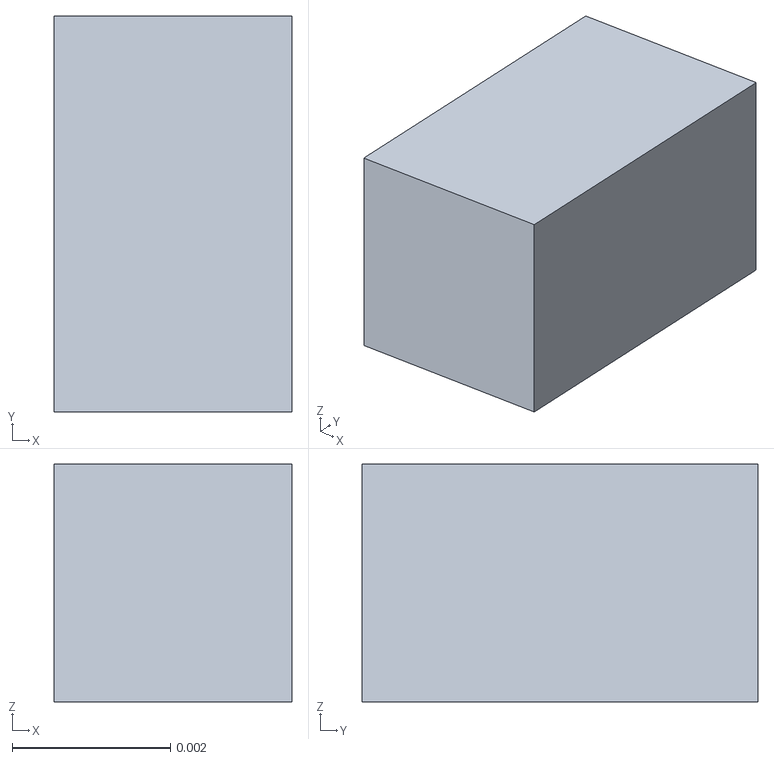
[picture p42: CAD file, 2026-09-11]
assets/geometry/Cheek_handle_root_3.stl
0.003 x 0.005 x 0.003
