youngskylty/SensoSpoon/assets/geometry/Roll_drive_bridge.stl

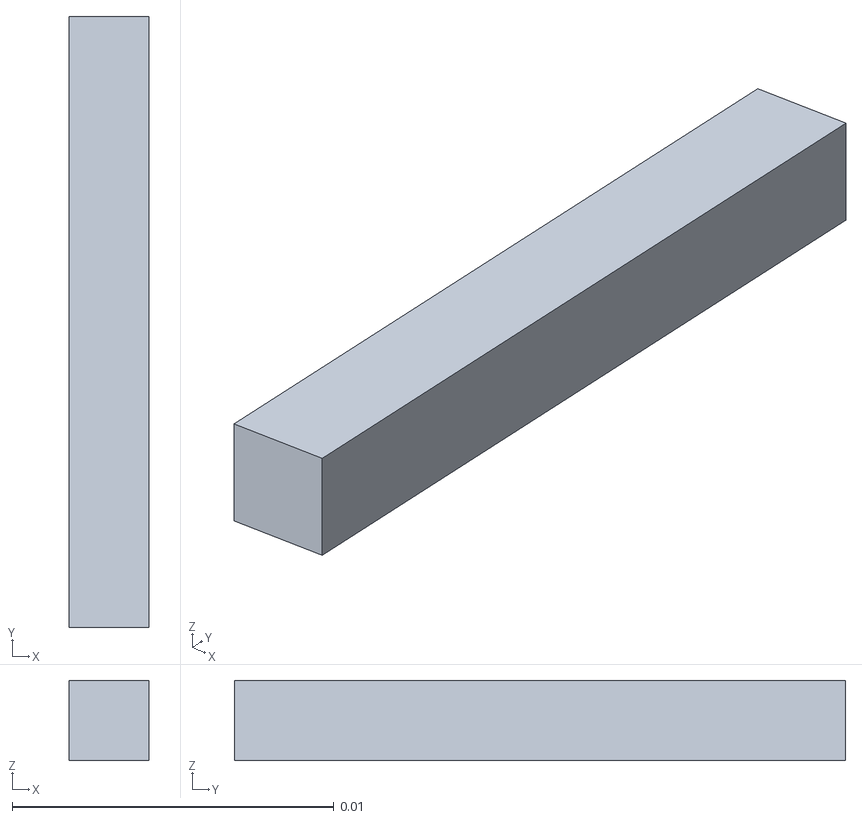
[picture p43: CAD file, 2026-09-11]
assets/geometry/Roll_drive_bridge.stl
0.0025 x 0.019 x 0.0025
