youngskylty/SensoSpoon/assets/geometry/VCA_A_housing.stl

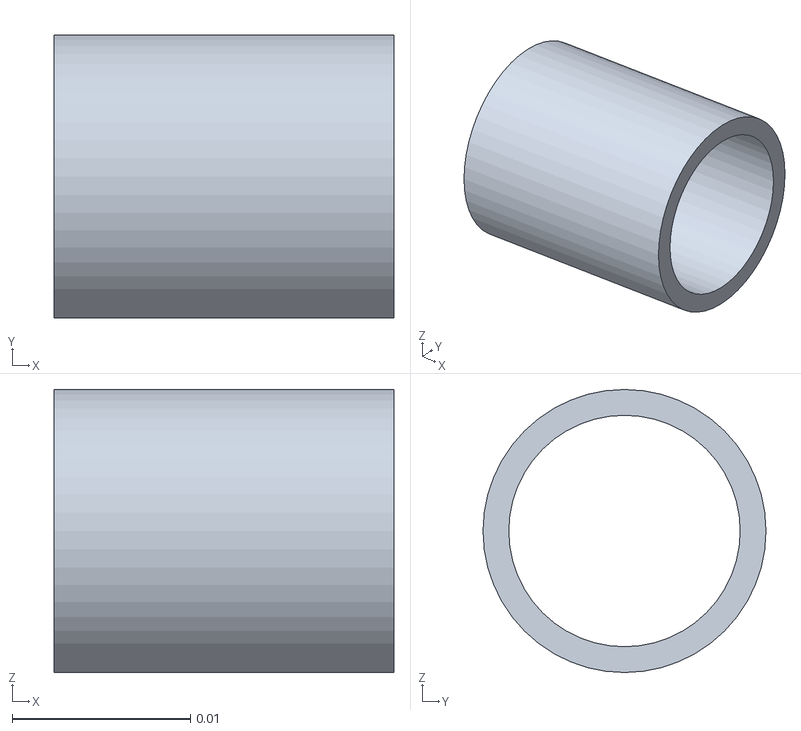
[picture p44: CAD file, 2026-09-11]
assets/geometry/VCA_A_housing.stl
0.0191 x 0.0159 x 0.0159
