youngskylty/SensoSpoon/assets/geometry/VCA_A_plunger.stl

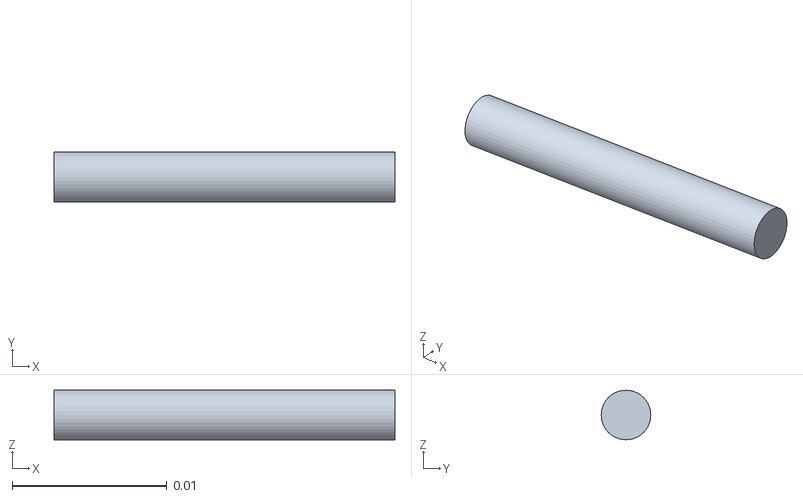
[picture p45: CAD file, 2026-09-11]
assets/geometry/VCA_A_plunger.stl
0.022 x 0.0032 x 0.0032
