youngskylty/SensoSpoon/assets/geometry/DRV8876_A.stl

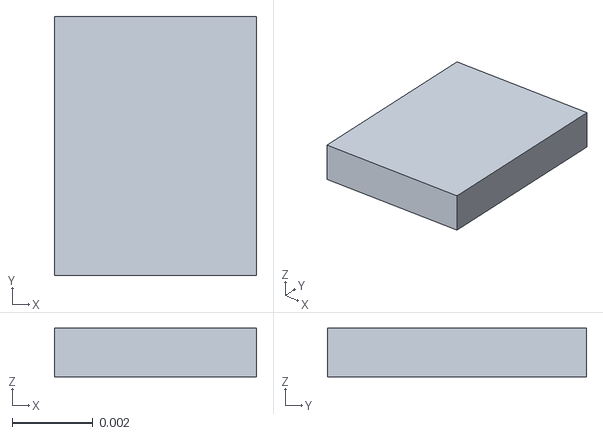
[picture p46: CAD file, 2026-09-11]
assets/geometry/DRV8876_A.stl
0.005 x 0.0064 x 0.0012
