youngskylty/SensoSpoon/assets/geometry/Bayonet_pin.stl

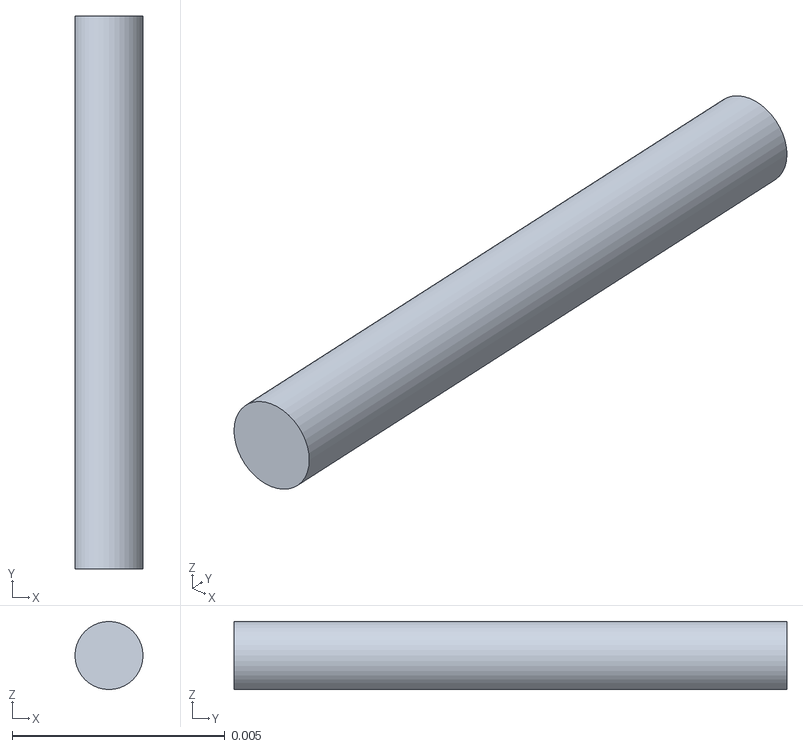
[picture p47: CAD file, 2026-09-11]
assets/geometry/Bayonet_pin.stl
0.0016 x 0.013 x 0.0016
