youngskylty/SensoSpoon/assets/geometry/Gimbal_socket_B.stl

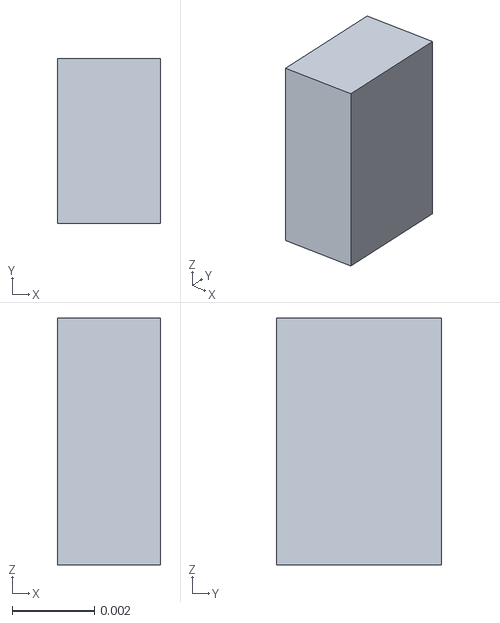
[picture p48: CAD file, 2026-09-11]
assets/geometry/Gimbal_socket_B.stl
0.0025 x 0.004 x 0.006
