youngskylty/SensoSpoon/assets/geometry/Bellows_seal.stl

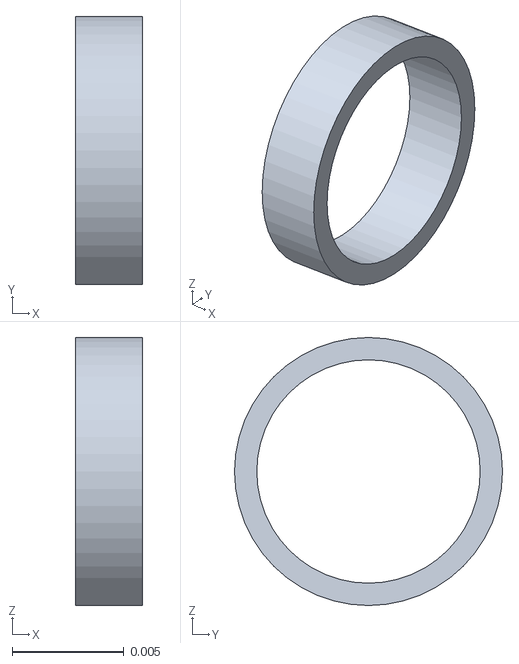
[picture p49: CAD file, 2026-09-11]
assets/geometry/Bellows_seal.stl
0.003 x 0.012 x 0.012
