youngskylty/SensoSpoon/assets/geometry/Slider_joint_A.stl

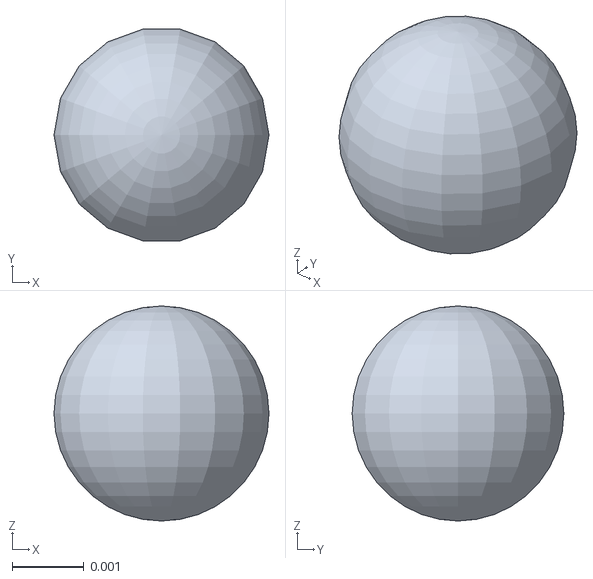
[picture p50: CAD file, 2026-09-11]
assets/geometry/Slider_joint_A.stl
0.003 x 0.00295 x 0.003
