youngskylty/SensoSpoon/assets/geometry/Ball_carrier_rib_209.stl

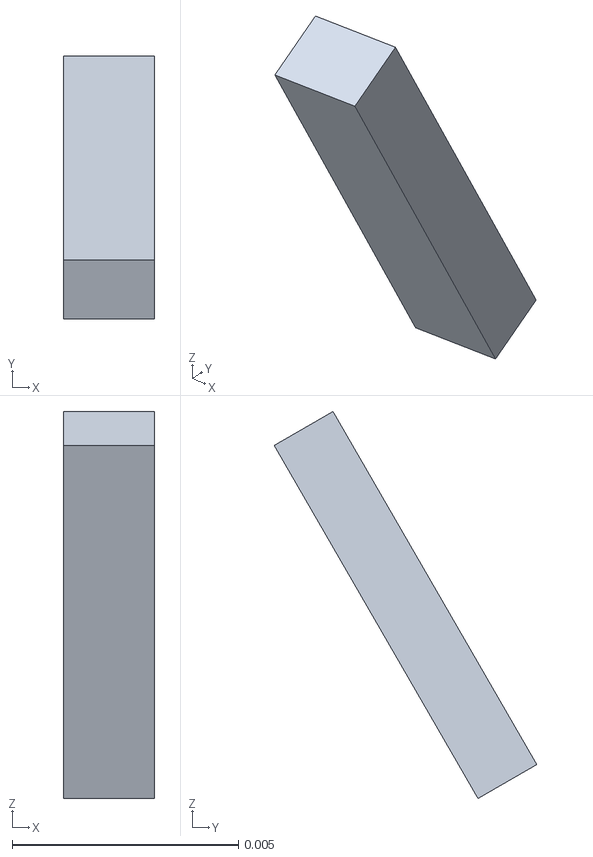
[picture p51: CAD file, 2026-09-11]
assets/geometry/Ball_carrier_rib_209.stl
0.002 x 0.0058 x 0.00854
