youngskylty/SensoSpoon/assets/geometry/VCA_A_mount.stl

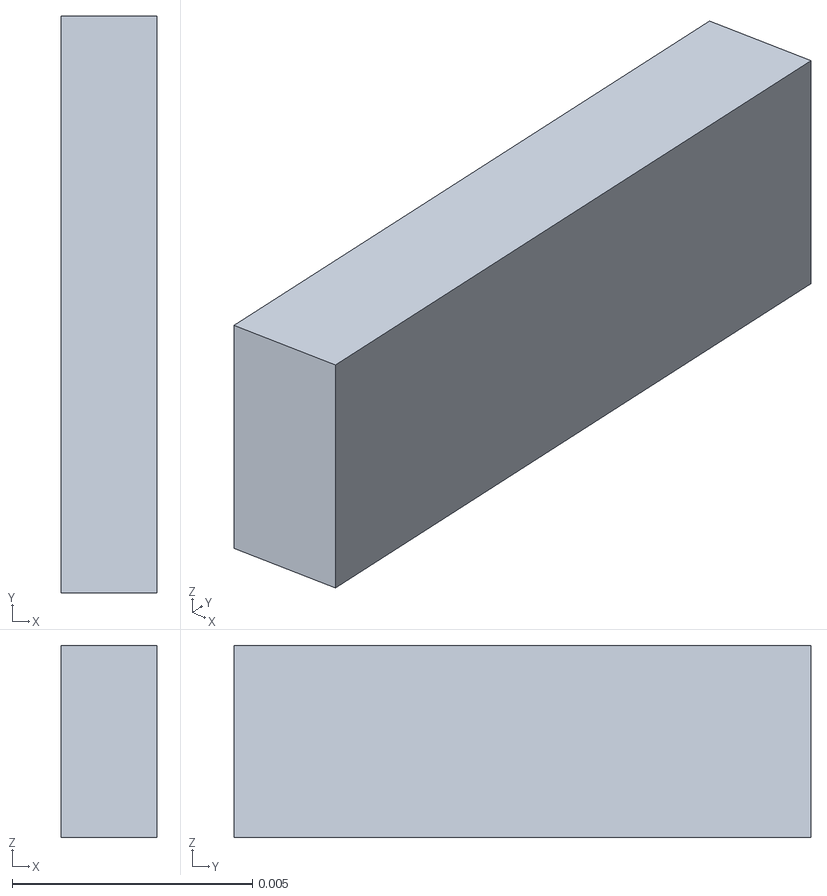
[picture p52: CAD file, 2026-09-11]
assets/geometry/VCA_A_mount.stl
0.002 x 0.012 x 0.004
