youngskylty/SensoSpoon/assets/geometry/Ball_carrier_rib_0.stl

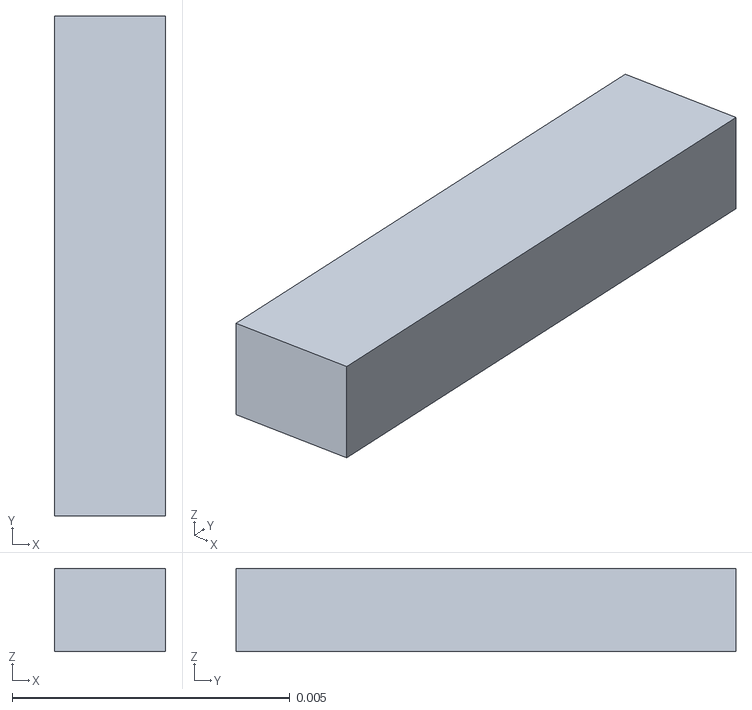
[picture p53: CAD file, 2026-09-11]
assets/geometry/Ball_carrier_rib_0.stl
0.002 x 0.009 x 0.0015
