youngskylty/SensoSpoon/assets/geometry/Quick_release_collar.stl

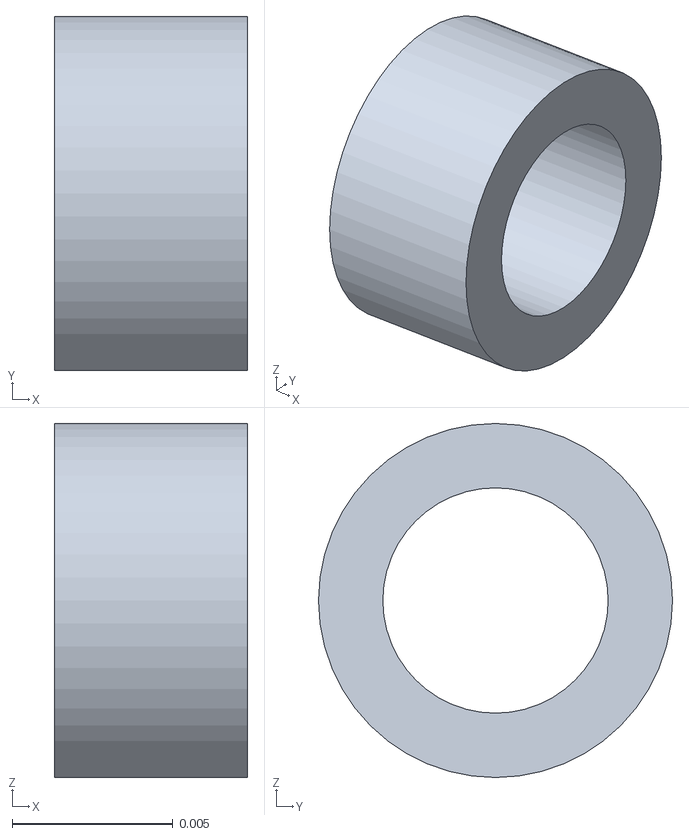
[picture p54: CAD file, 2026-09-11]
assets/geometry/Quick_release_collar.stl
0.006 x 0.011 x 0.011
