youngskylty/SensoSpoon/assets/geometry/Cflex_D10_fixed.stl

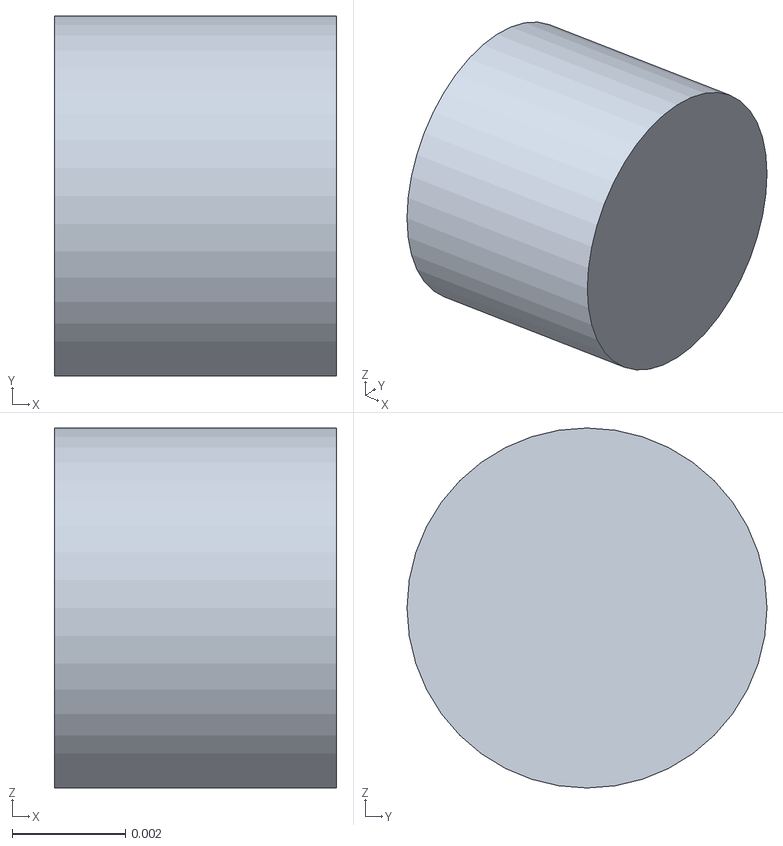
[picture p55: CAD file, 2026-09-11]
assets/geometry/Cflex_D10_fixed.stl
0.00498 x 0.00635 x 0.00635
