youngskylty/SensoSpoon/assets/geometry/Side_cheek_3.stl

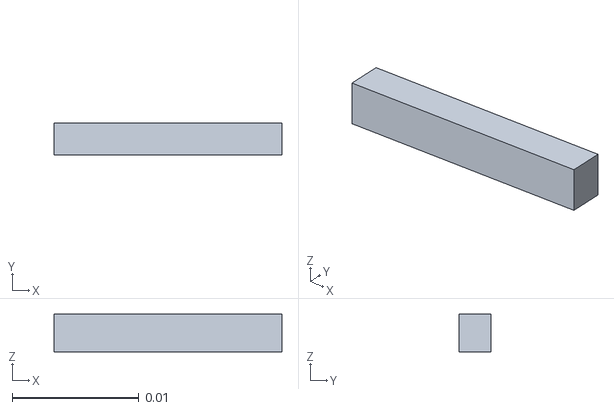
[picture p56: CAD file, 2026-09-11]
assets/geometry/Side_cheek_3.stl
0.018 x 0.0025 x 0.003
