youngskylty/SensoSpoon/assets/geometry/Cflex_B10_moving_3.stl

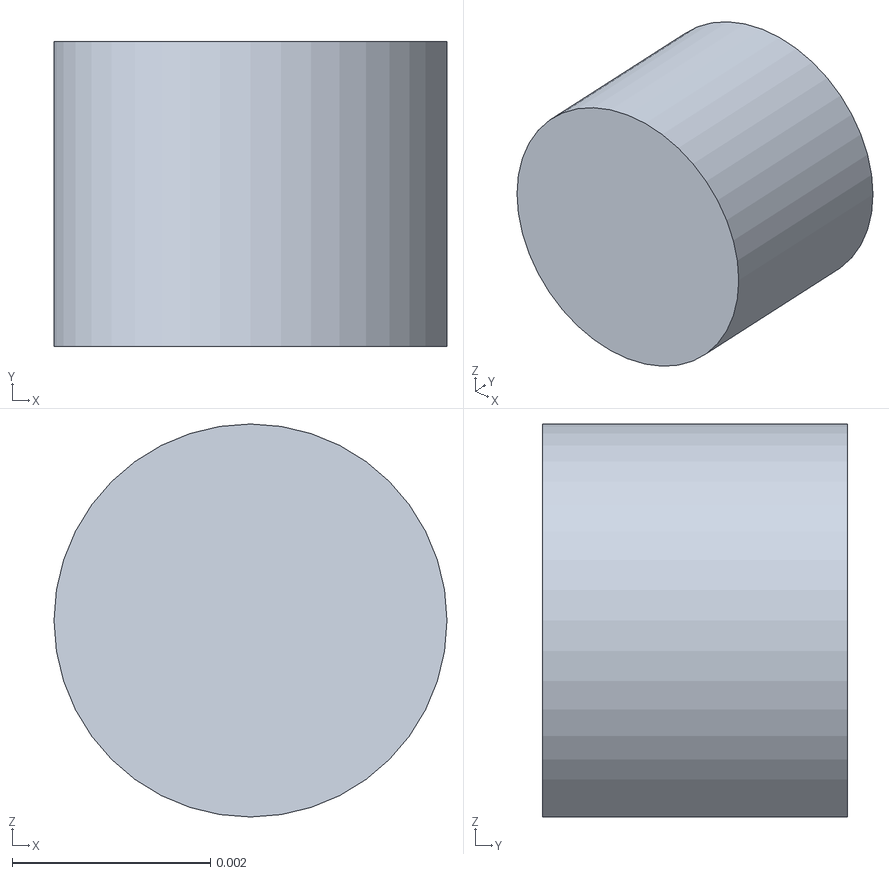
[picture p57: CAD file, 2026-09-11]
assets/geometry/Cflex_B10_moving_3.stl
0.00397 x 0.00308 x 0.00397
