youngskylty/SensoSpoon/assets/geometry/Static_balance_mass.stl

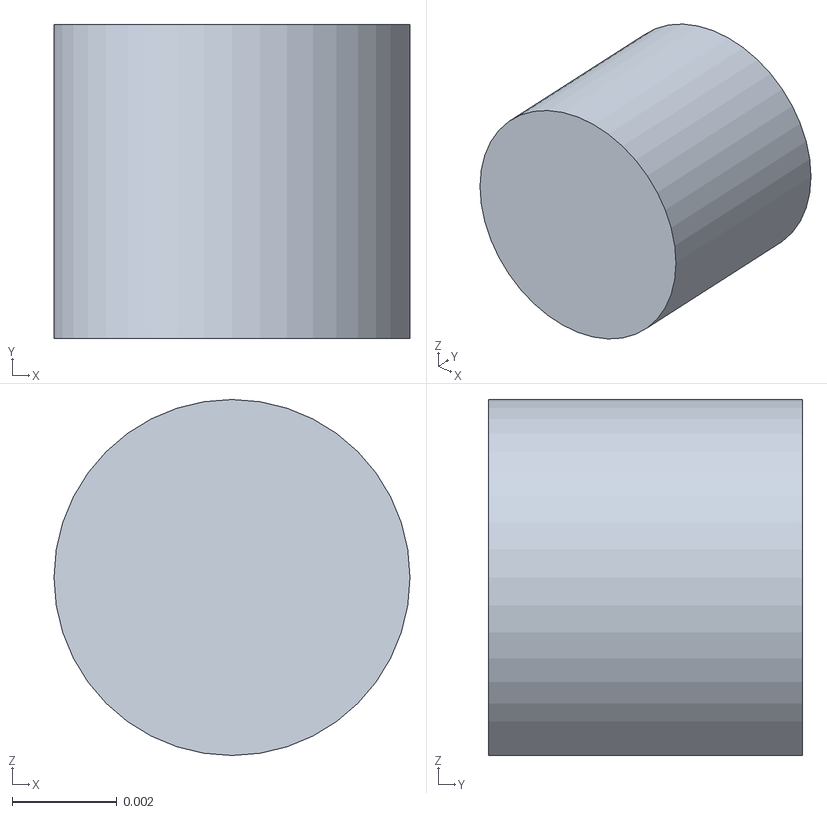
[picture p59: CAD file, 2026-09-11]
assets/geometry/Static_balance_mass.stl
0.0068 x 0.006 x 0.0068
