youngskylty/SensoSpoon/assets/geometry/Shell_upper.stl

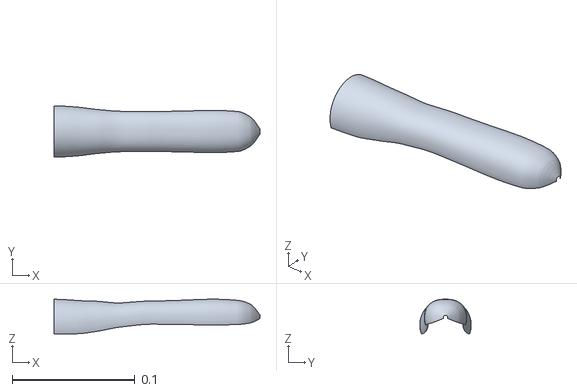
[picture p60: CAD file, 2026-09-11]
assets/geometry/Shell_upper.stl
0.168 x 0.042 x 0.0283
