youngskylty/SensoSpoon/assets/geometry/Pitch_fixed_seat_1.stl

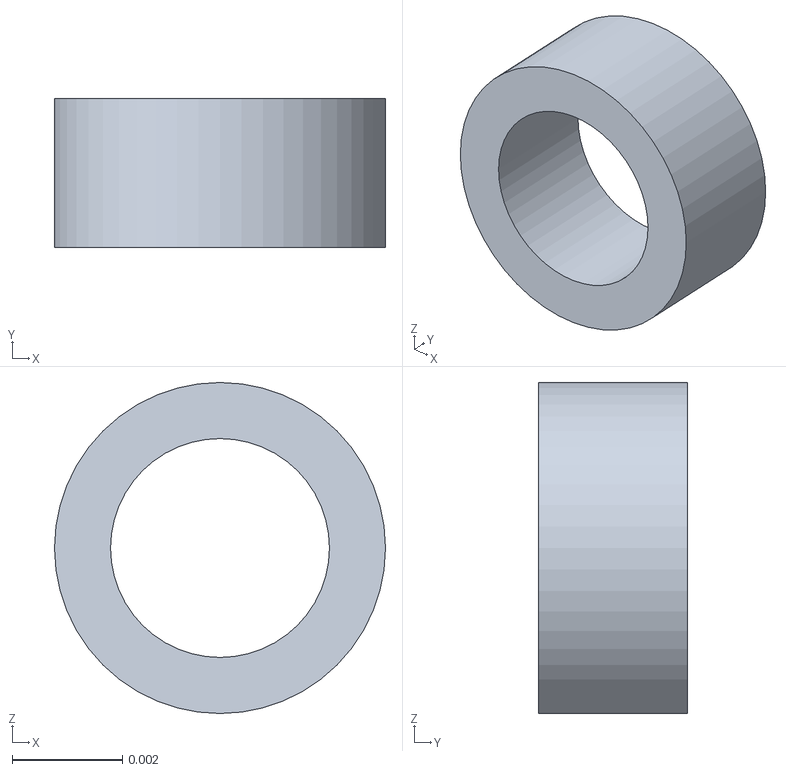
[picture p61: CAD file, 2026-09-11]
assets/geometry/Pitch_fixed_seat_1.stl
0.006 x 0.0027 x 0.006
