youngskylty/SensoSpoon/assets/geometry/Spherical_fixed_bezel.stl

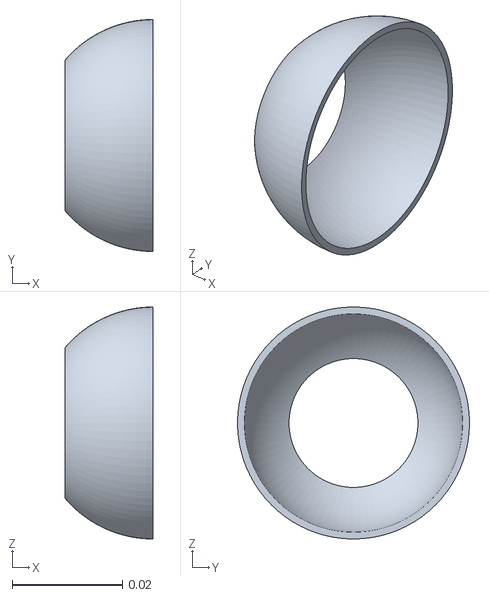
[picture p62: CAD file, 2026-09-11]
assets/geometry/Spherical_fixed_bezel.stl
0.016 x 0.042 x 0.042
