youngskylty/SensoSpoon/assets/geometry/Pushrod_B.stl

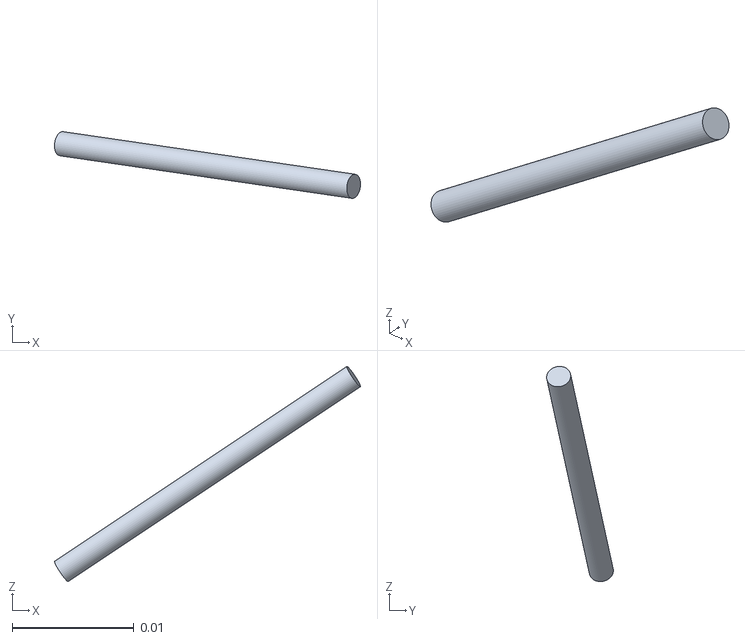
[picture p63: CAD file, 2026-09-11]
assets/geometry/Pushrod_B.stl
0.0251 x 0.00548 x 0.0177
