youngskylty/SensoSpoon/assets/geometry/Status_LED_4.stl

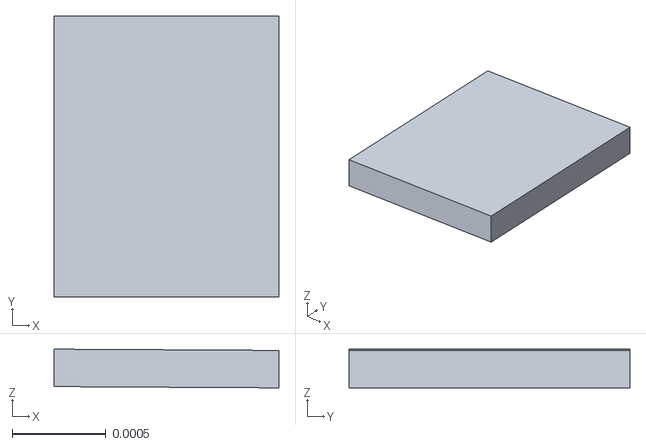
[picture p64: CAD file, 2026-09-11]
assets/geometry/Status_LED_4.stl
0.0012 x 0.0015 x 0.000207
