youngskylty/SensoSpoon/assets/geometry/Gimbal_saddle_root.stl

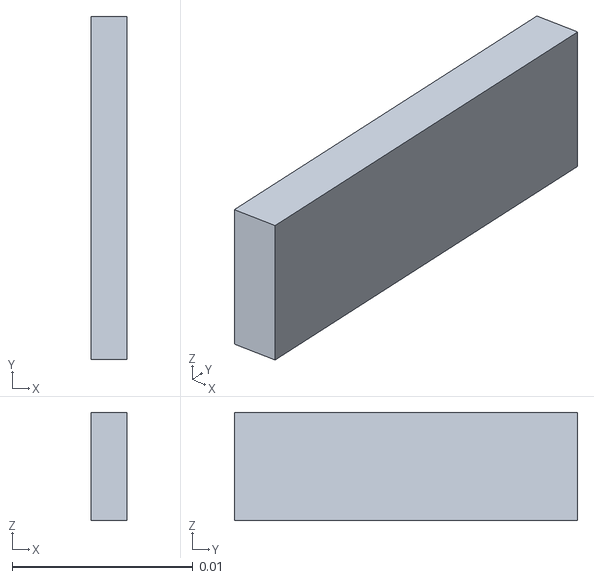
[picture p65: CAD file, 2026-09-11]
assets/geometry/Gimbal_saddle_root.stl
0.002 x 0.019 x 0.006
