youngskylty/SensoSpoon/assets/geometry/Roll_moving_collet.stl

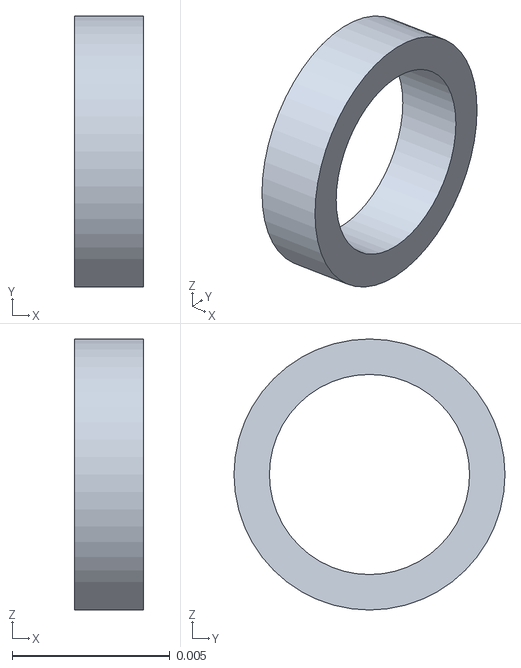
[picture p66: CAD file, 2026-09-11]
assets/geometry/Roll_moving_collet.stl
0.0022 x 0.0086 x 0.0086
