youngskylty/SensoSpoon/assets/geometry/Spoon_IMU_PCB.stl

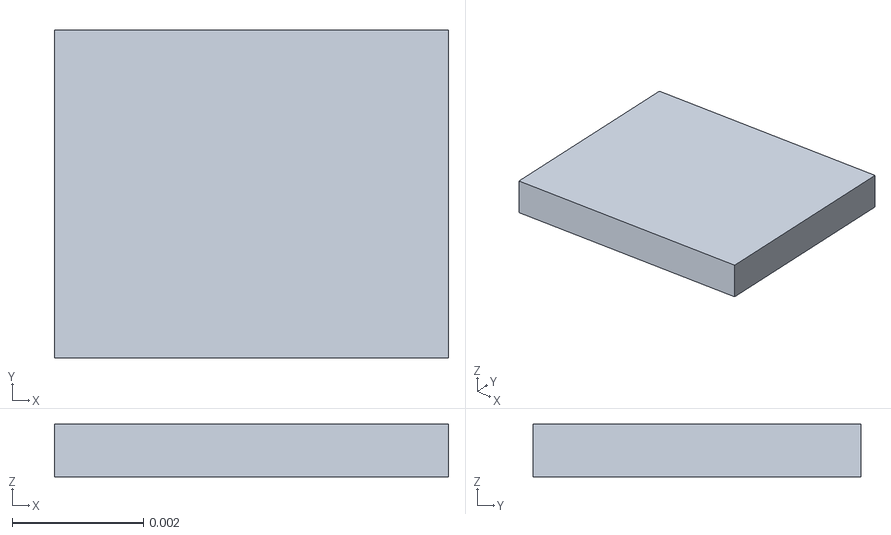
[picture p67: CAD file, 2026-09-11]
assets/geometry/Spoon_IMU_PCB.stl
0.006 x 0.005 x 0.0008
