youngskylty/SensoSpoon/assets/geometry/Floating_yoke_hub.stl

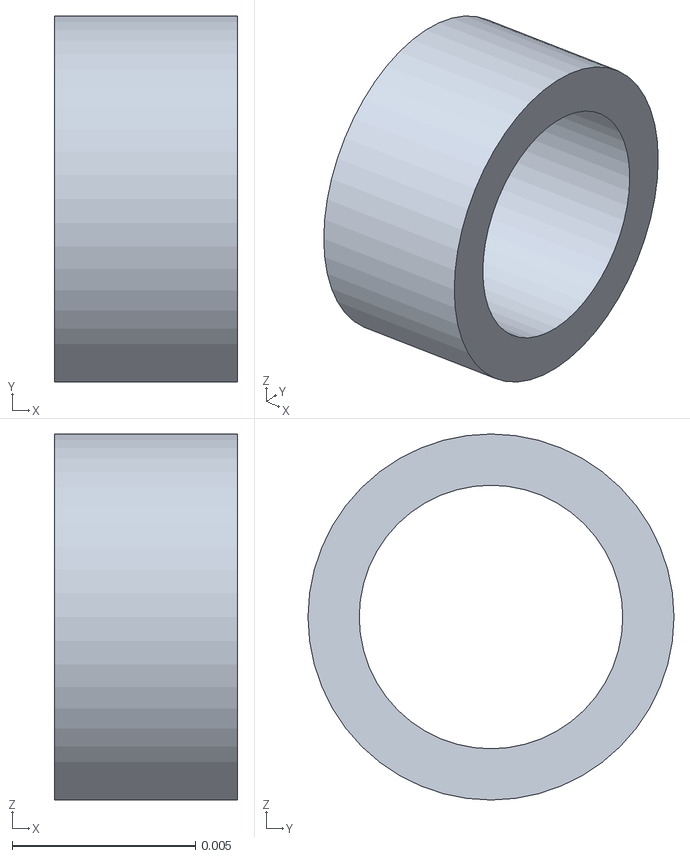
[picture p68: CAD file, 2026-09-11]
assets/geometry/Floating_yoke_hub.stl
0.005 x 0.01 x 0.01
