youngskylty/SensoSpoon/assets/geometry/LiPo_2S_pouch.stl

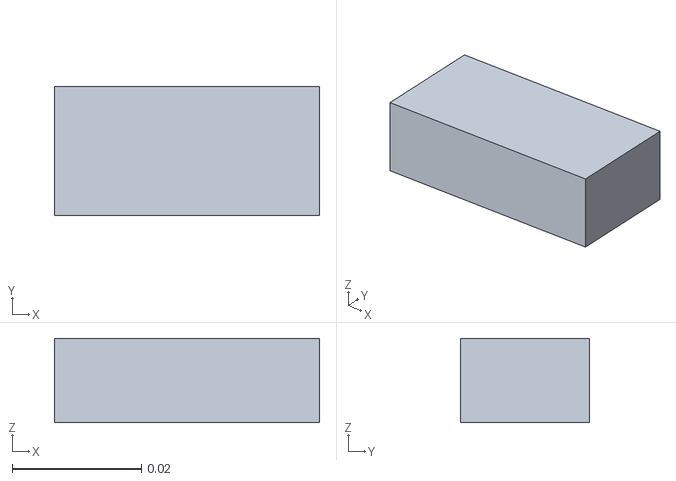
[picture p69: CAD file, 2026-09-11]
assets/geometry/LiPo_2S_pouch.stl
0.041 x 0.02 x 0.013
