youngskylty/SensoSpoon/assets/geometry/Handle_front_cap.stl

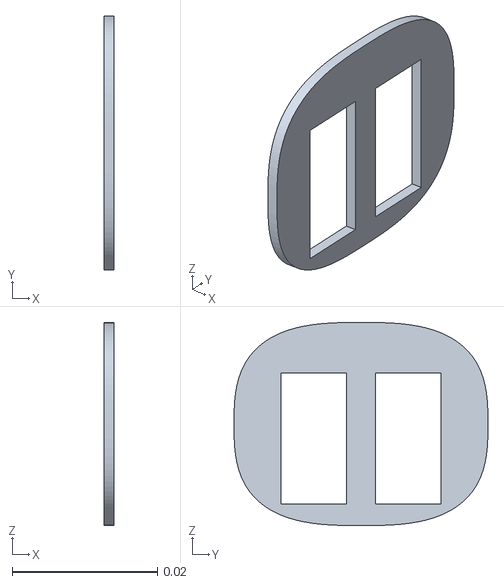
[picture p70: CAD file, 2026-09-11]
assets/geometry/Handle_front_cap.stl
0.0014 x 0.035 x 0.028
