youngskylty/SensoSpoon/assets/geometry/Spoon_BMI270.stl

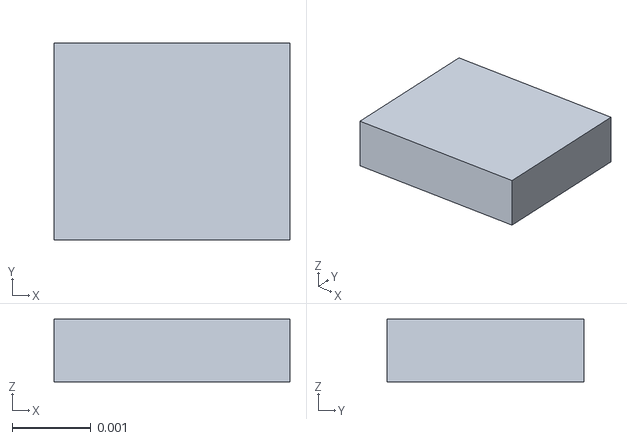
[picture p71: CAD file, 2026-09-11]
assets/geometry/Spoon_BMI270.stl
0.003 x 0.0025 x 0.0008
