youngskylty/SensoSpoon/assets/geometry/Status_LED_1.stl

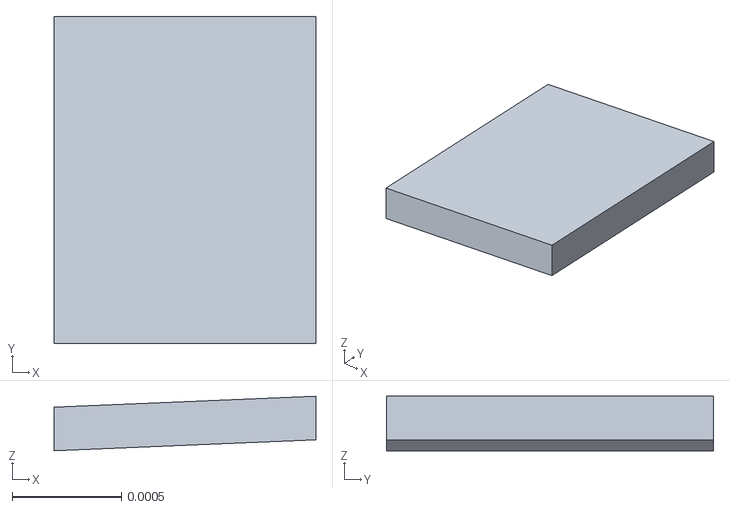
[picture p72: CAD file, 2026-09-11]
assets/geometry/Status_LED_1.stl
0.0012 x 0.0015 x 0.00025
