youngskylty/SensoSpoon/assets/geometry/Spherical_moving_carrier.stl

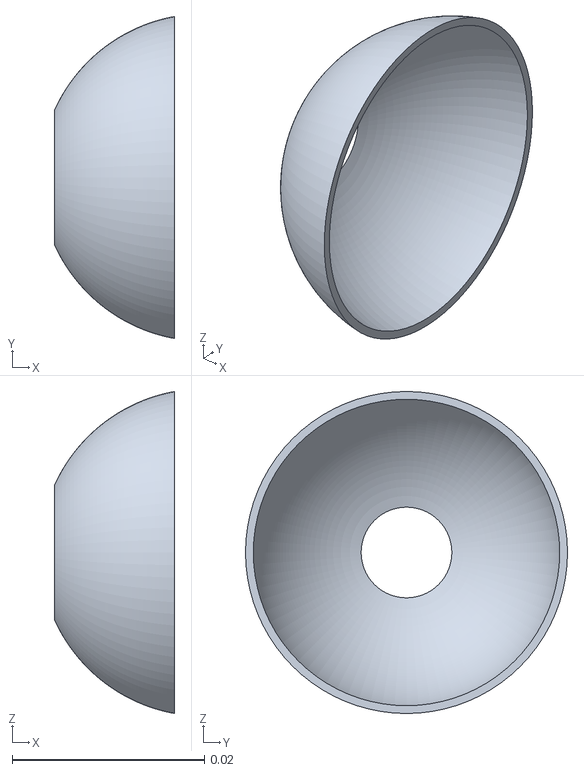
[picture p73: CAD file, 2026-09-11]
assets/geometry/Spherical_moving_carrier.stl
0.0125 x 0.0335 x 0.0335
