youngskylty/SensoSpoon/assets/geometry/Shell_lower.stl

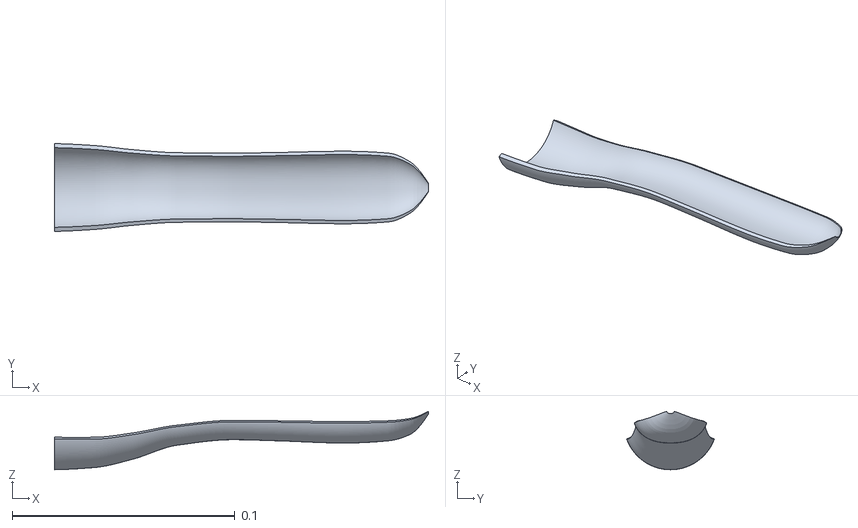
[picture p74: CAD file, 2026-09-11]
assets/geometry/Shell_lower.stl
0.168 x 0.0395 x 0.0263
