youngskylty/SensoSpoon/assets/geometry/VCA_B_rear.stl

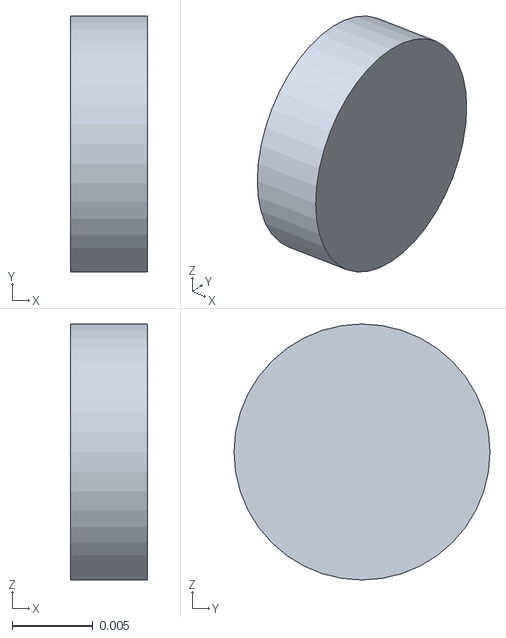
[picture p75: CAD file, 2026-09-11]
assets/geometry/VCA_B_rear.stl
0.0048 x 0.0159 x 0.0159
