youngskylty/SensoSpoon/assets/geometry/B_shaft_extension.stl

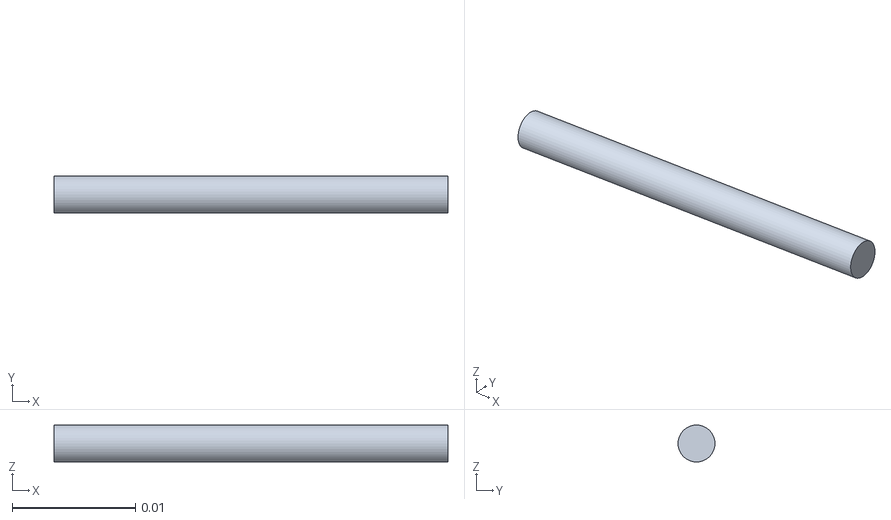
[picture p76: CAD file, 2026-09-11]
assets/geometry/B_shaft_extension.stl
0.032 x 0.003 x 0.003
