youngskylty/SensoSpoon/assets/geometry/PCB.stl

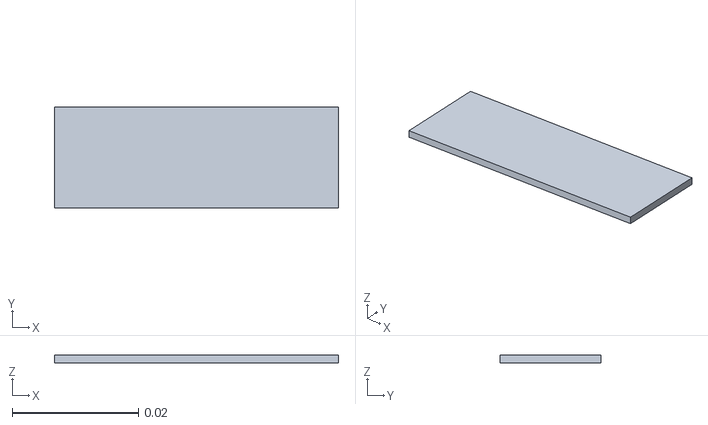
[picture p77: CAD file, 2026-09-11]
assets/geometry/PCB.stl
0.045 x 0.016 x 0.0012
