youngskylty/SensoSpoon/assets/geometry/Control_panel.stl

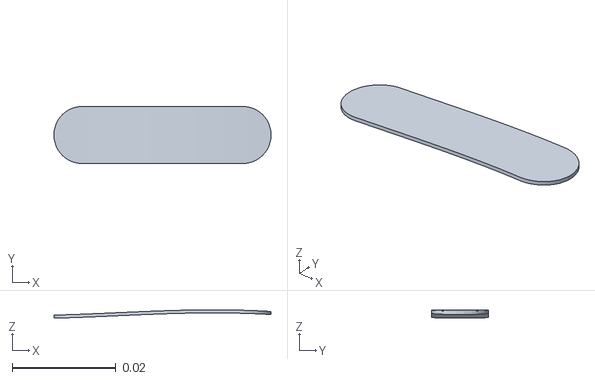
[picture p78: CAD file, 2026-09-11]
assets/geometry/Control_panel.stl
0.0419 x 0.011 x 0.00163
