youngskylty/SensoSpoon/assets/geometry/Spoon_bowl.stl

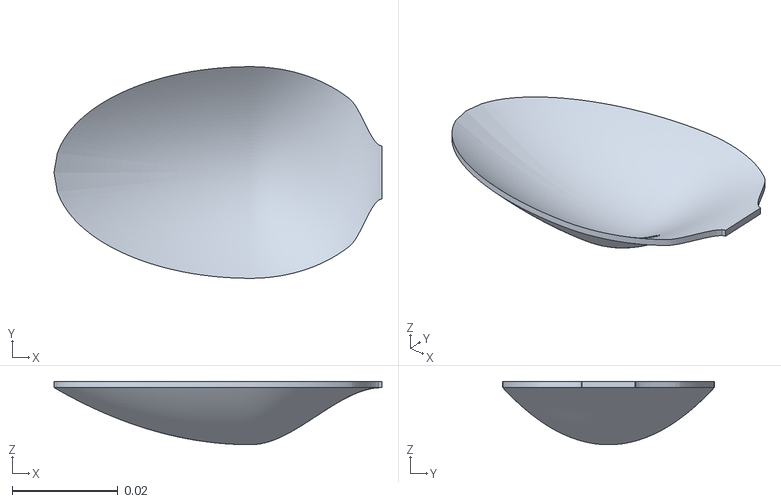
[picture p80: CAD file, 2026-09-11]
assets/geometry/Spoon_bowl.stl
0.062 x 0.04 x 0.012
