youngskylty/SensoSpoon/assets/geometry/USB_C.stl

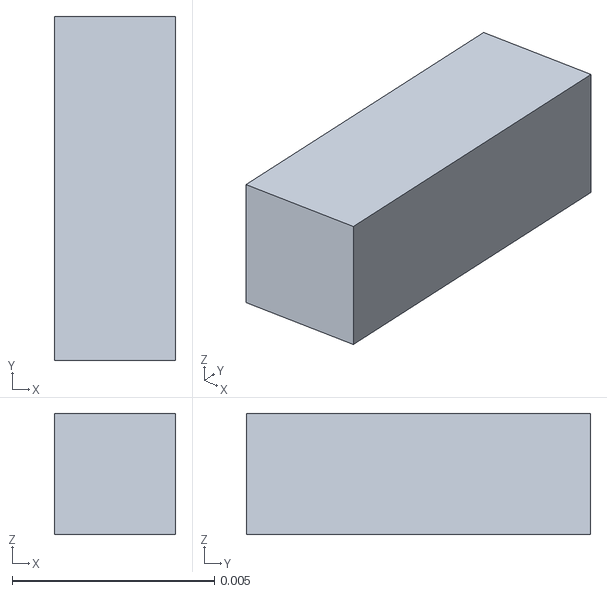
[picture p81: CAD file, 2026-09-11]
assets/geometry/USB_C.stl
0.003 x 0.0085 x 0.003
