youngskylty/SensoSpoon/assets/geometry/Power_button.stl

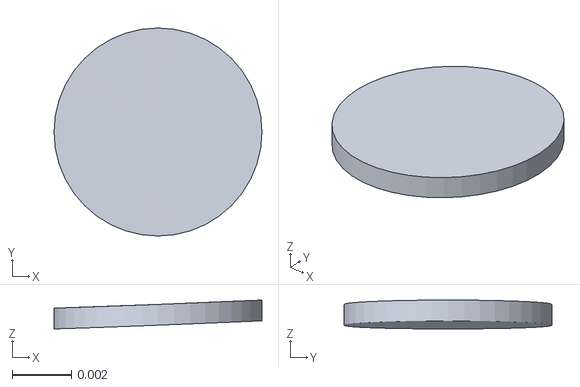
[picture p82: CAD file, 2026-09-11]
assets/geometry/Power_button.stl
0.007 x 0.007 x 0.000973
