youngskylty/SensoSpoon/assets/geometry/VCA_B_winding.stl

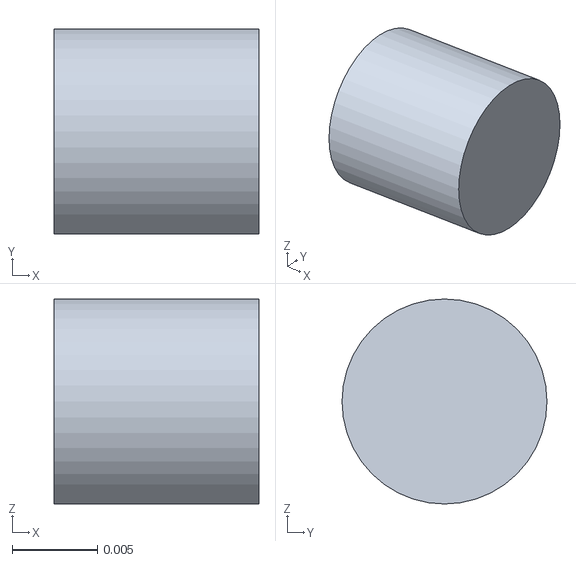
[picture p83: CAD file, 2026-09-11]
assets/geometry/VCA_B_winding.stl
0.012 x 0.012 x 0.012
