youngskylty/SensoSpoon/assets/geometry/STM32G431CB_MCU.stl

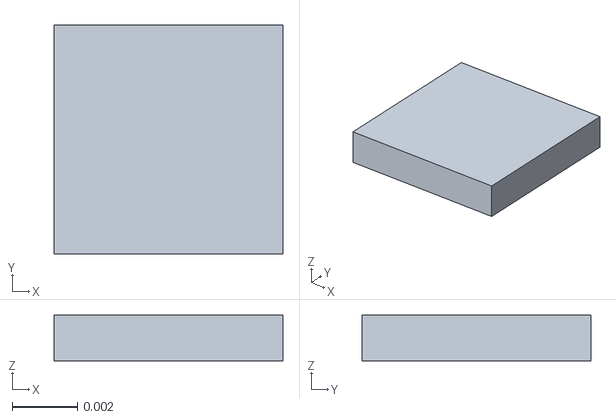
[picture p84: CAD file, 2026-09-11]
assets/geometry/STM32G431CB_MCU.stl
0.007 x 0.007 x 0.0014
