youngskylty/SensoSpoon/assets/geometry/Gimbal_rear_saddle.stl

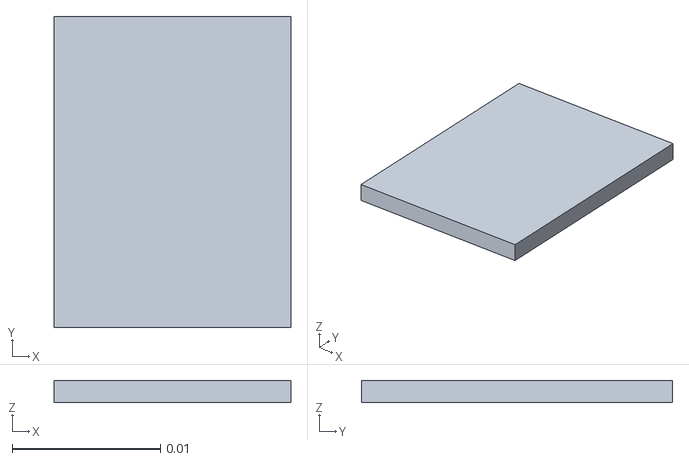
[picture p85: CAD file, 2026-09-11]
assets/geometry/Gimbal_rear_saddle.stl
0.016 x 0.021 x 0.0015
