youngskylty/SensoSpoon/(list of files, cad)

Other CAD files:
assets/geometry/Coil_B_turn_04.stl
assets/geometry/Coil_A_turn_05.stl
assets/geometry/VCA_B_housing.stl
assets/geometry/Coil_B_turn_09.stl
assets/geometry/Coil_A_turn_01.stl
assets/geometry/Cflex_B10_fixed_1.stl
assets/geometry/Cflex_B10_moving_1.stl
assets/geometry/Coil_A_turn_03.stl
assets/geometry/Coil_B_turn_01.stl
assets/geometry/Coil_B_turn_05.stl
assets/geometry/Side_cheek_1.stl
assets/geometry/Rod_end_A.stl
assets/geometry/Gimbal_socket_A.stl
assets/geometry/VCA_B_plunger.stl
assets/geometry/Cheek_handle_root_1.stl
assets/geometry/Coil_B_turn_08.stl
assets/geometry/Slider_joint_B.stl
assets/geometry/Coil_B_turn_03.stl
assets/geometry/Pitch_fixed_seat_3.stl
assets/geometry/Pitch_bridge.stl
assets/geometry/Cflex_B10_fixed_3.stl
assets/geometry/VCA_B_mount.stl
assets/geometry/DRV8876_B.stl
assets/geometry/BMI270_IMU.stl
assets/geometry/Coil_A_turn_02.stl
assets/geometry/Coil_A_turn_06.stl
assets/geometry/Pushrod_A.stl
assets/geometry/Rod_end_B.stl
assets/geometry/Cflex_D10_moving.stl
assets/geometry/Coil_A_turn_04.stl
assets/geometry/Ball_carrier_rib_419.stl
assets/geometry/Coil_B_turn_06.stl
assets/geometry/VCA_A_rear.stl
assets/geometry/Coil_A_turn_08.stl
assets/geometry/Coil_B_turn_07.stl
assets/geometry/Coil_B_turn_02.stl
assets/geometry/Coil_A_turn_07.stl
assets/geometry/VCA_A_winding.stl
