youngskylty/SensoSpoon/output/results/control_numerical_verification.csv

mechanical_step_s | joint_difference_rms_deg | joint_difference_peak_deg | attitude_rms_deg | suppression_difference_points
0.0005 | 0.00249676342640857 | 0.0113924344948883 | 0.0346621064232096 | 0.0740924503729445
0.00025 | 0.00113189545529482 | 0.00458431127314586 | 0.0342552199066319 | 0.0333798831603218
0.0001 | 0.00043044756715071 | 0.00156943708829502 | 0.0341321765895647 | 0.0210683193407561
