youngskylty/SensoSpoon/output/results/fast_movement_closed_loop.csv

arm | scenario | seed | attitude_rms_deg | suppression_percent | tremor_leak_deg | intent_track_deg
IMU-only (no gate) | reach | 4243 | 0.288718698402201 | 71.1246536087338 | 0.210984022764636 | 0.271192277327484
IMU-only (no gate) | reach | 9401 | 0.289032868559279 | 71.0932328100061 | 0.21073380589133 | 0.266553392635024
IMU-only (no gate) | reach | 9402 | 0.28914800876294 | 71.0817174032012 | 0.210706147348394 | 0.266468391448544
IMU-only (no gate) | reach | 9403 | 0.289237912426964 | 71.072725954241 | 0.210692241020267 | 0.266446766082214
IMU-only (no gate) | sine | 4243 | 0.063926792709121 | 93.6065509668269 | 0.00884272627876527 | 0.0391856309462496
IMU-only (no gate) | sine | 4243 | 0.103284608334842 | 89.6702954846374 | 0.0381180087789732 | 0.044469456772659
A amplitude | reach | 4243 | 0.6971019471036 | 30.2814112697277 | 0.526055729287633 | 0.67180048958314
A amplitude | reach | 9401 | 0.693560486033174 | 30.6356000205971 | 0.538408207282265 | 0.666064288505795
A amplitude | reach | 9402 | 0.701539376772832 | 29.8376148703429 | 0.542928142774777 | 0.67379040079832
A amplitude | reach | 9403 | 0.694213618325257 | 30.5702789268212 | 0.52495412007336 | 0.669817281678415
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
