youngskylty/SensoSpoon/output/results/analytic_hardware_validation.csv

LockedRotorStepError_A | ReversedPolarityError_A | PayloadResponseDifference_rad
8.36711394613943e-10 | 0 | 0.0157265950603053
