youngskylty/SensoSpoon/output/results/control_benchmark.csv

arm | algorithm | intent_model | osc2 | semg_fusion | case_id | scenario | frequency_Hz | amplitude_deg | payload_g | bus_V | mechanical_step_s | attitude_rms_deg | baseline_rms_deg | suppression_percent | roll_rms_deg | pitch_rms_deg | attitude_peak_deg | startup_rms_deg | position_rms_mm | baseline_position_rms_mm | current_peak_A | current_rms_A | voltage_peak_V | stroke_peak_mm | joint_peak_deg | power_mean_W | temperature_rise_K | allocation_saturation_percent | side_load_peak_N | current_utilization_percent | stroke_utilization_percent | within_limits | meets_90_percent_target | hardware_feasible
simple_pid | simple_pid | cv_legacy | 0 | off | 1 | sine | 4 | 1 | 5 | 7.4 | 0.0005 | 0.0152359012774186 | 0.999879601408101 | 98.4762264120638 | 0.00999830234772968 | 0.0114954437870763 | 0.174237758698098 | 0.0635594247922409 | 0.810191614703417 | 1.62358275959305 | 0.574376695231499 | 0.490205975033409 | 3.05695058814711 | 0.335967546440712 | 1.11824830511172 | 1.10702426465987 | 0.545769364294656 | 0 | 0.596000161036012 | 38.2917796821 | 5.29082750300333 | 1 | 1 | 1
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
