youngskylty/SensoSpoon/output/results/control_benchmark_summary.csv

arm | algorithm | intent_model | semg_fusion | mean_all_scored | mean_feasible | mean_in_envelope | n_feasible | worst_feasible | case10_voluntary_rms_deg | n_meets_90_of_feasible | peak_current_A | peak_mean_power_W
simple_pid | simple_pid | cv_legacy | off | 64.1927928381809 | 90.2339215593443 | 90.2339215593443 | 16 | 51.5118901108668 | 0.45833235515728 | 15 | 1.44059573481947 | 5.72685065592735
ekf_cv | ekf_predictive | cv | off | 71.0280568125093 | 92.1218615476244 | 92.1218615476244 | 16 | 85.8826099585925 | 0.200752743686004 | 11 | 1.43054221372467 | 5.72277940460832
ekf_cv_legacy | ekf_predictive | cv_legacy | off | 68.7469892269169 | 88.9574311136547 | 88.9574311136547 | 16 | 30.745475813888 | 1.2389825468166 | 11 | 1.43074616440717 | 5.72276977584264
ekf_cv_osc2 | ekf_predictive | cv | off | 71.0394805436454 | 92.1275207044896 | 92.1275207044896 | 16 | 85.898600080532 | 0.200800785949597 | 11 | 1.43053473247497 | 5.72630408436112
ekf_cv_qfix | ekf_predictive | cv | intent_gate_fixed | 65.6173351144225 | 85.1791520604597 | 85.1791520604597 | 16 | -41.4120449827131 | 3.04178489978753 | 15 | 1.43310659382487 | 5.84805567964979
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
