youngskylty/SensoSpoon/output/results/control_training.csv

intent_hz | bandwidth_hz | rms_4Hz | rms_8Hz | rms_12Hz | intent_error_deg
0.8 | 25 | 0.0380016418292662 | 0.0594938747697847 | 0.12523436358708 | 2.64544077882458
0.8 | 35 | 0.0397625973288708 | 0.0376662037298394 | 0.0703944011804422 | 2.64468007643805
1 | 25 | 0.059049055424592 | 0.0581319477035111 | 0.124136014109447 | 2.10540903680176
1 | 35 | 0.0611503031314171 | 0.0378094467665094 | 0.0695040396239994 | 2.10462129343914
1.2 | 25 | 0.0860624507559155 | 0.0574105683300705 | 0.122781285045337 | 1.74690748166303
1.2 | 35 | 0.0880465392511274 | 0.0386317362797711 | 0.0683241555852698 | 1.74606553499549
