youngskylty/SensoSpoon/output/figures/omega_capture_experiment.png

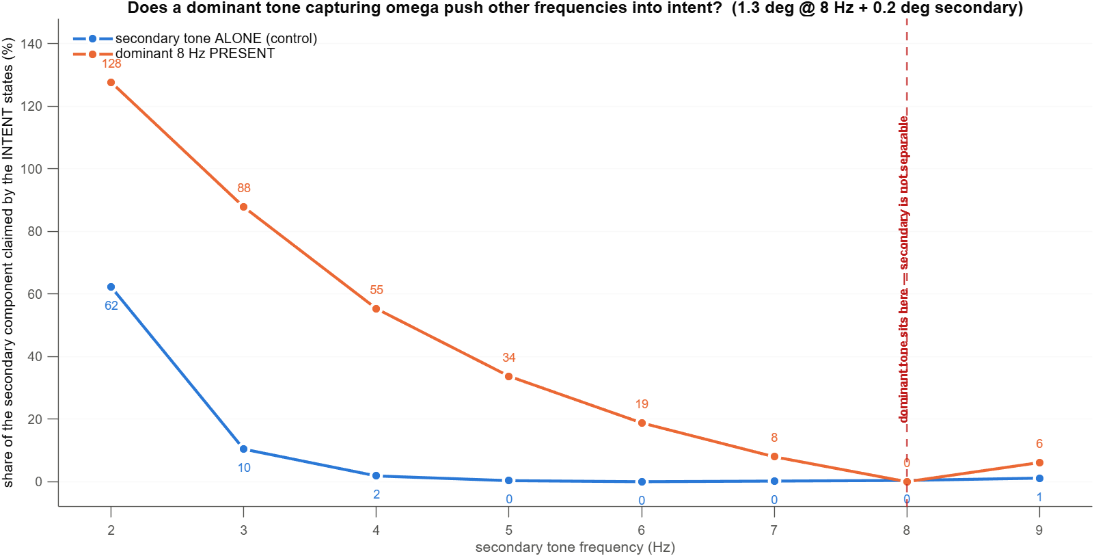
output/figures/omega_capture_experiment.png
