youngskylty/SensoSpoon/output/figures/rcflex_physical_test.png

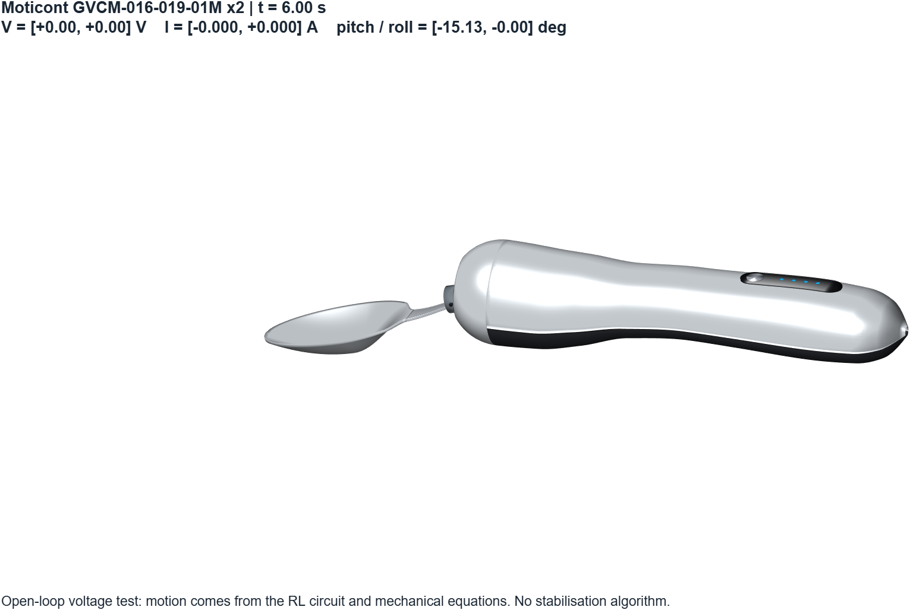
output/figures/rcflex_physical_test.png
