youngskylty/SensoSpoon/output/figures/semg_characterization.png

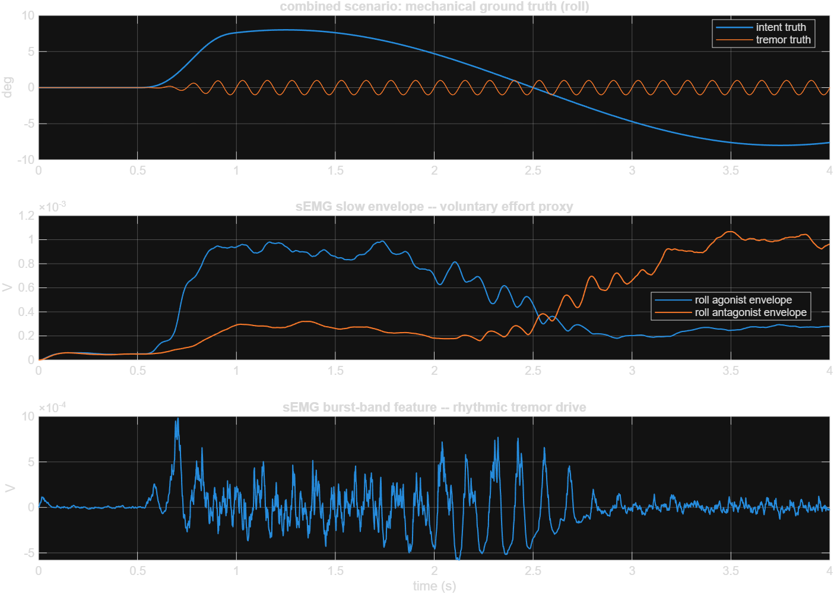
output/figures/semg_characterization.png
