youngskylty/SensoSpoon/output/figures/spoon_dimension_verification.png

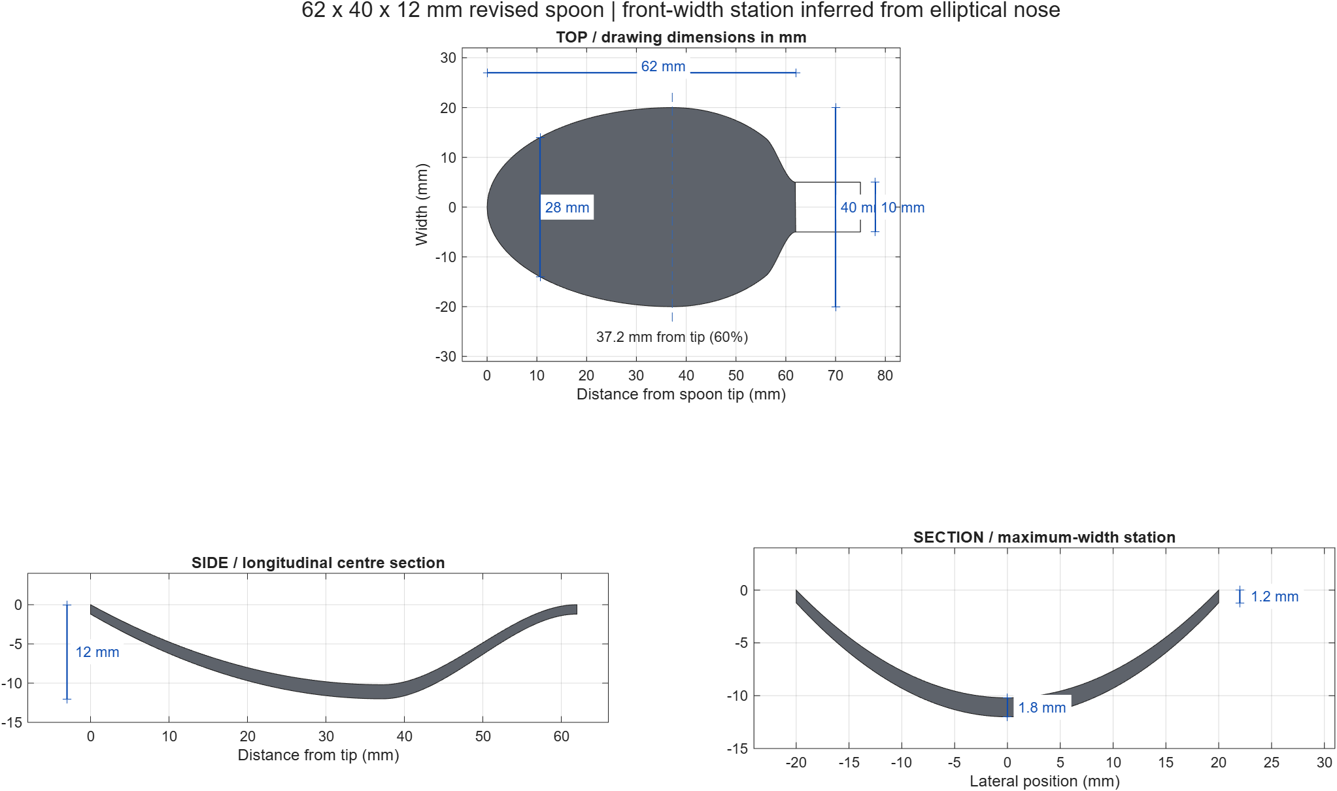
output/figures/spoon_dimension_verification.png
