youngskylty/SensoSpoon/docs/sources/GVCM-016-019-01M.pdf

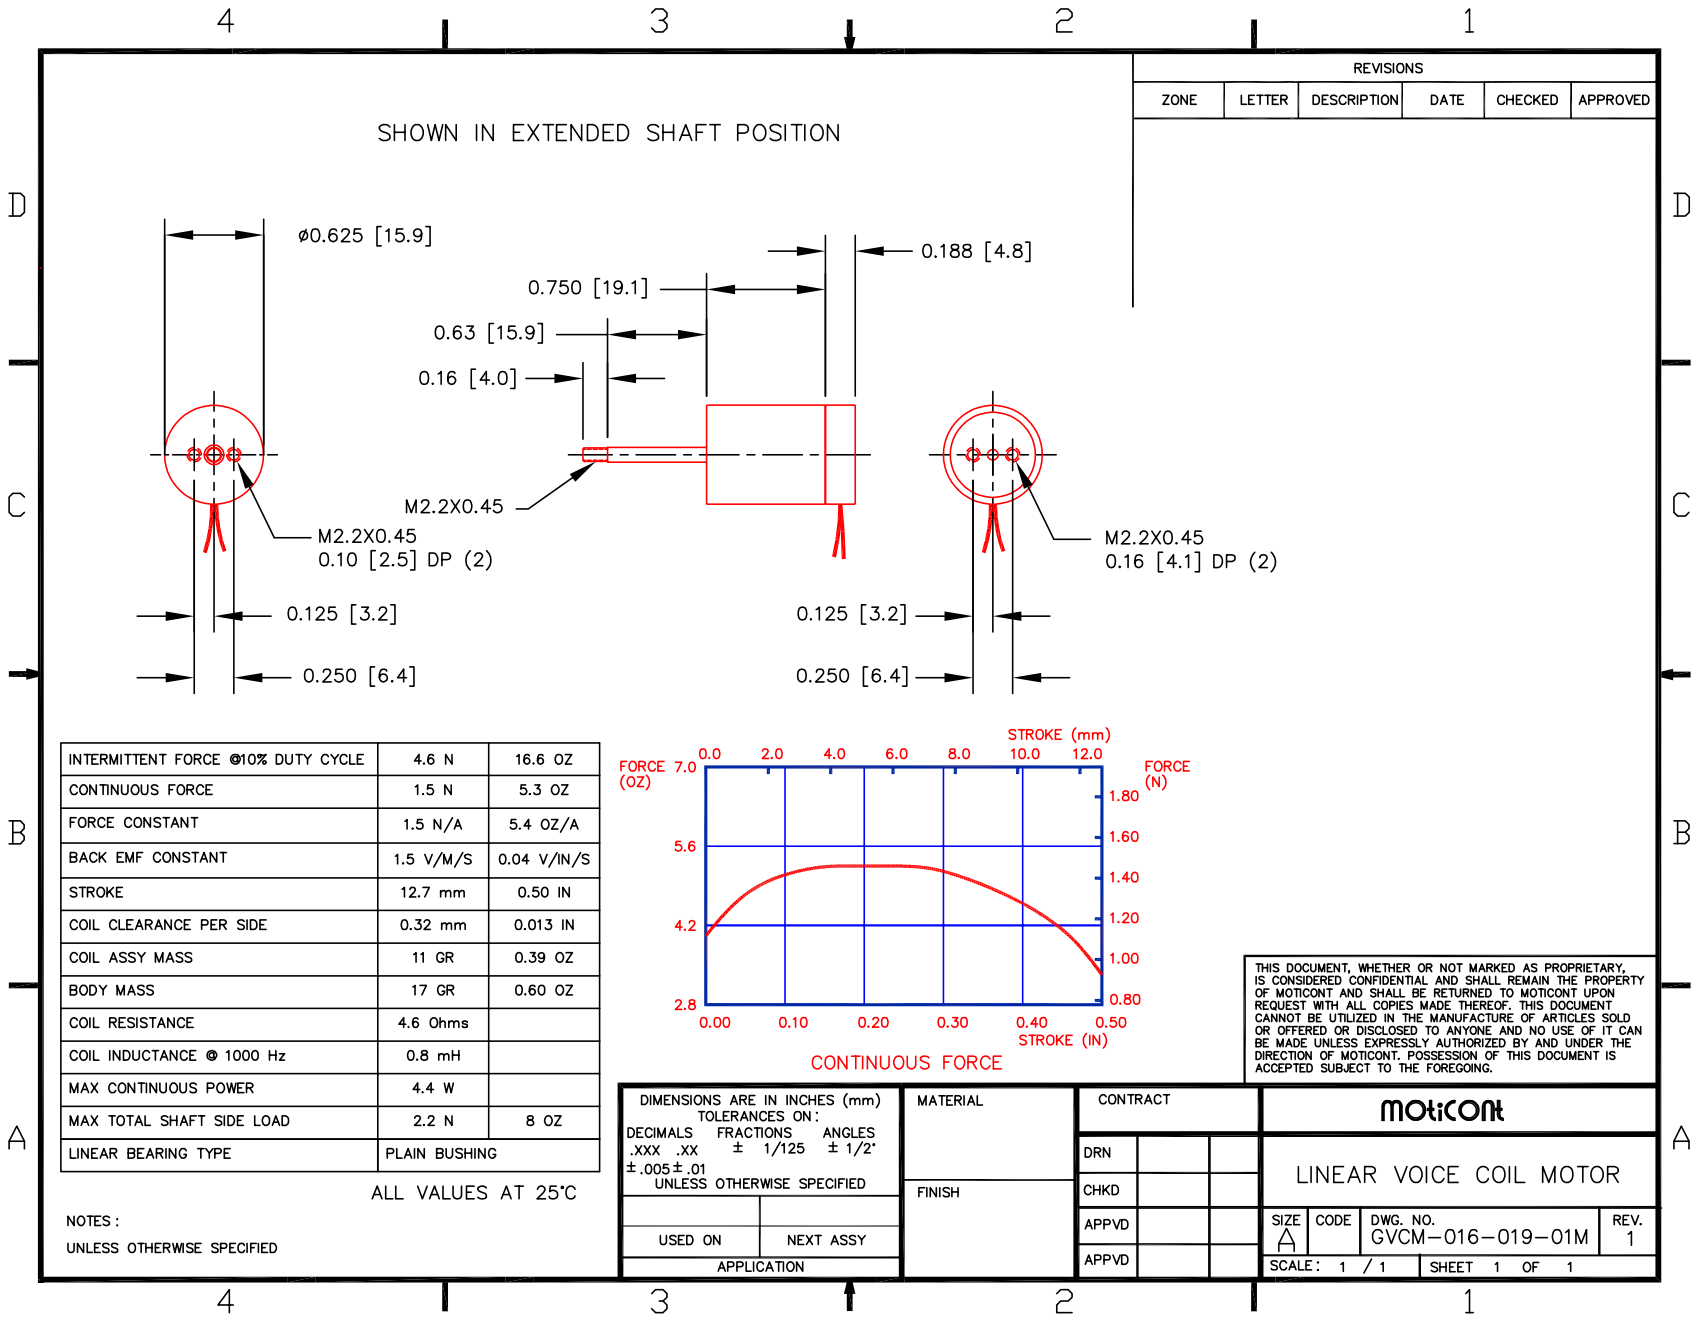
[picture p94: page 1]
