youngskylty/SensoSpoon/(commit log)

2026-10-05 Add 13-state EKF intent/tremor estimator core
    Implements the estimator specified in docs/CONTROL_IMPROVEMENT_PLAN.md:
    a joint (shared-omega) EKF over voluntary intent (2 axes) and a
    two-harmonic tremor oscillator, plus an NIS-based trust gate.
    - rcflex_intent_ekf_init.m: constant Q/H/R/x0/P0 and state index map.
    - rcflex_intent_ekf_step.m: predict/update, omega clamp (2-25 Hz),
    NIS trust gate. Pure function, no persistent state (determinism
    required by tests/test_rcflex_control.m).
    - rcflex_control_parameters.m: new C.algorithm switch
    ('simple_pid' default, unchanged | 'ekf_predictive', new) plus the
    EKF/authority tuning fields. All existing simple_pid fields and
    behaviour are unt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
2026-10-05 Add predictive authority manager and shared inverse-dynamics helper
    - rcflex_required_current.m: the coil-current inverse-dynamics
    calculation extracted from evaluate_rcflex_envelope.m so the offline
    feasibility sweep and the online authority manager cannot drift
    apart, per docs/CONTROL_IMPROVEMENT_PLAN.md. evaluate_rcflex_envelope.m
    refactored to call it; no behaviour change (same computation, same
    outputs).
    - rcflex_authority_manager.m: propagates the EKF's two-harmonic
    oscillator state forward analytically over C.auth_horizon_s,
    evaluates the required current/joint-travel at several points via
    rcflex_required_current, and derates authority (rate-limited) before
    the alloc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
2026-10-05 Wire EKF + authority manager into rcflex_attitude_step
    Replace only the reference-path section of the outer loop (per
    docs/CONTROL_IMPROVEMENT_PLAN.md Step 4): everything before it
    (dual-IMU attitude estimation) and after it (guard/rate limiting,
    error formation, PID, feedforward, 9-case current allocator) is
    byte-identical for both algorithms.
    - C.algorithm='ekf_predictive' now runs the EKF -> trust-gate blend
    -> authority-manager chain to produce `ref`, instead of the fixed
    notch/lead/lowpass IIR cascade. C.algorithm='simple_pid' is
    unaffected (verified: tests/test_rcflex_control.m still passes
    unchanged).
    - Controller state z widened 100 -> 300: EKF slice at z(101:283)
    (13-stat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
2026-10-05 Rate-limit EKF omega updates; full 20-case benchmark comparison
    Found (via the 'combined' scenario, case 9): every test scenario opens
    with a quintic amplitude ramp (0->full over 0.5-1.0s), and during that
    ramp the fundamental's amplitude is near zero, making the omega
    Jacobian nearly singular. A single sample could then propose an
    implausibly large omega jump (observed up to 60 Hz/s) with no real
    tremor behind it, occasionally driving omega into the 2 Hz clamp and
    taking >1s to recover -- a false lock, not a real transient response.
    Tried and rejected: gating the omega process noise by fundamental
    amplitude (too small an effect, since the pre-existing covariance
    already carries most of the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
2026-10-05 Add independent frequency observable to the EKF intent estimator
    The joint intent + two-harmonic-tremor + shared-omega model is weakly
    identifiable while voluntary intent and tremor amplitude ramp together
    (the 'combined' scenario): the near-constant-velocity intent states can
    absorb part of the oscillation, so the data is explained almost as well
    at a wrong omega as at the right one. The filter false-locks low while
    staying internally self-consistent, which is why the measurement NIS --
    a single-step "does this sample fit" statistic -- stays near zero and
    cannot detect the failure. Gating or slowing the single omega adaptation
    law cannot fix this; it only trades false-lock robustness agains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
2026-10-05 Fix animation frame-size drift; regenerate figures and analytic results
    VideoWriter rejects frames whose size differs from the first one, which
    getframe can produce when the figure is resized mid-render. Capture the
    first frame's size and imresize any later frame that disagrees.
    Regenerated open-loop figures, videos and analytic validation outputs
    alongside it; the numerical deltas are solver-noise level (rod closure
    error 6.9e-18 -> 3.5e-18 m, solver angle difference 2.4658e-7 ->
    2.4670e-7 rad).
    Claude-Session: https://claude.ai/code/session_01BFHw8qmPzArHn7dEQWxVg5
2026-10-05 Add standalone sEMG sensing subsystem, not fused with the IMU
    Brings surface EMG into the system as a sensing stage only. Nothing here reads
    sEMG into the reference path, the EKF measurement model or the state vector;
    deciding what the estimator should take from it is deliberately deferred until
    the characterisation evidence exists.
    Single switch: C.semg_enabled (default false). With it off the system is the
    IMU-only baseline, verified bit-identical to the pre-sEMG code on the reference
    case -- plant states, sensor samples and diagnostic columns 1:24 all isequal,
    max|dY| = 0.
    Entry point. The stream is passed as an optional trailing argument to
    rcflex_attitude_step(z,sensor,H,B,C,semgBlock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
2026-10-05 Document the sEMG requirements, hardware design and characterisation results
    docs/SEMG_SUBSYSTEM.md specifies the subsystem as a standalone stage: signal
    requirements derived from what the software actually assumes, a buildable
    sensor, component selection, the simulation/hardware correspondence, and the
    tests a real dataset must pass before fusion is attempted. Requirements not
    driven by our pipeline are marked [not required] so they do not get built by
    accident -- notably the 24-bit biopotential front end, whose extra resolution
    this millivolt-scale, AC-coupled signal cannot use.
    Headline specs: 4 channels, 4000 Hz (integer multiple of the 800 Hz control
    rate), 20-450 Hz, 0.7 mV rms / 6.8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
2026-10-05 Model the analogue anti-alias stage on an oversampled analogue domain
    Adds the one hardware block the acquisition model was missing: a 2-pole
    Butterworth at C.semg_aa_Hz = 480 Hz, applied after the gain stage and before
    sampling. The chain is now, in physical order:
    electrode -> corruptions -> AC coupling -> gain -> anti-alias -> decimate
    -> quantise/clip
    Two of those orderings are requirements rather than preferences: AC coupling
    must precede gain (the electrode offset is ~10x the signal), and anti-aliasing
    must precede sampling.
    For the filter to mean anything the analogue domain is now modelled at
    C.semg_hz * C.semg_oversample = 16 kHz and decimated to 4 kHz after filtering.
    Genera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
2026-10-05 Add the real-sEMG dataset path and the six-stage validation gate
    Prepares for standalone real-data validation. No fusion, no EKF change: this is
    the gate that decides whether fusion is justified at all, and it runs before any
    estimator work.
    A recorded dataset now goes through exactly the same preprocessing, features and
    quality checks as the synthetic source. C.semg_source='file' is implemented in
    rcflex_semg_source.m, and rcflex_semg_dataset_spec.m is the single definition of
    the field contract -- callable with no arguments to return the contract, so a
    recording or conversion script can be written against it rather than against
    prose.
    The spec rejects the mistakes a real dataset will act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
2026-10-05 Document the anti-alias stage and the real-dataset format; regenerate results
    SEMG_SUBSYSTEM.md 4.2 changes from a gap to a resolved item, and gains 6: the
    dataset field contract, the minimum useful dataset, the recording protocol, how
    to run the gate, and the thresholds with their synthetic reference values.
    Characterisation regenerated after the anti-alias change. SNR 8.0-12.7 dB, lead
    35-37.5 ms, burst frequency 7.81-9.38 Hz against a true 8 Hz, separation 8.1x --
    unchanged in substance from the pre-filter numbers.
    One caveat is recorded prominently rather than buried: the stage-3 cross-talk
    reference of |r| = 0.19 is an artefact, not a prediction. The synthetic source
    generates channel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
2026-10-05 Add the permanent sEMG implementation reference
    docs/SEMG_IMPLEMENTATION.md: a concise standing reference for the sEMG
    subsystem -- purpose, architecture, files, signal specification, sampling and
    synchronisation, preprocessing, the synthetic source, the real-data interface,
    the proposed physical sensor, characterisation results, limitations, what is
    deliberately not implemented, and the next validation stage.
    Records the exact state it documents: ekf_osc2=false, semg_enabled=false by
    default, algorithm='simple_pid', EKF unmodified, no sEMG/IMU fusion, the
    frequency-estimation experiment reverted, and the IMU-only baseline unchanged
    at 94.9769% suppression / 0.050225 deg RMS.
    Written as a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
2026-10-05 Add GRABMyo as the real-sEMG test case; cross-talk assumption validated
    Selects, documents and imports a real forearm sEMG dataset for the six-stage
    validation gate. No fusion, no EKF change, no threshold change.
    Dataset: GrabMyo v1.1.0 (PhysioNet, doi:10.13026/rzbf-ts96, CC BY 4.0). 16
    forearm electrodes as two rings of eight, 2048 Hz, 43 healthy participants,
    with isolated wrist flexion and extension gestures plus rest.
    The suggested Oxford candidate was investigated and rejected. "EMG and
    accelerometer recordings during closed-loop TMS..." is an ongoing clinical
    trial, not a released dataset; the closest published Oxford tremor dataset
    (phase-locked DBS, ORA uuid:4b3c7cea) was inspected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
2026-10-05 Redefine stage 3 as raw zero-lag cross-talk; split out stage 3b co-activation
    Stage 3 correlated ENVELOPES over the whole POOLED record. Both choices were
    wrong, and together they produced a confident PASS on a quantity that had never
    actually been measured.
    Envelope correlation measures shared neural drive, not electrical coupling: the
    synthetic source generates its four channels independently -- zero cross-talk by
    construction -- and still reports envelope |r| ~ 0.8 against raw |r| ~ 0.04.
    Pooling is separately invalid: flexion, extension and rest carry relationships of
    opposite sign, so one correlation over a multi-condition record cancels to near
    zero regardless of the underlying cross-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
2026-10-05 Withdraw the cross-talk conclusion; record the real-data stage 3 result
    Documents the stage 3 redefinition and retracts the conclusion that rested on the
    superseded metric.
    SEMG_DATASET.md previously reported stage 3 as 0.15/0.08 PASS against a 0.6
    threshold and concluded the reciprocal-activation assumption "survives contact
    with real data". That conclusion is withdrawn. Recomputed under the per-segment
    raw zero-lag definition, on the same GRABMyo recordings and with no threshold
    relaxed:
    P1 worst 0.460 median 0.331 FAIL
    P2 worst 0.262 median 0.129 PASS
    stage 3b coactivation_corr 0.63-0.78 (diagnostic)
    The split tracks electrode separation rather than subject: raw |r| decay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
2026-10-05 Add the sEMG->omega fusion experiment (E1); result does NOT support the hypothesis
    Implements the approved minimal fusion: the sEMG burst-band frequency as a
    scalar linear pseudo-measurement on EKF state 13 (omega). No new EKF states,
    states 1:12 stay IMU-only, confidence divides R from burst power, and the
    existing omega rate limit and 2-25 Hz bounds still apply afterwards.
    C.semg_fusion ('off'|'semg'|'oracle') is the only switch; with 'off' the
    simple_pid baseline is bit-identical at 94.9769 % / 0.050225 deg and all 14
    validation groups pass. The observable reuses the reserved ekfDiag(6:7) slots
    that carried the reverted Sec 1a estimator, so the diagnostic stays 32 wide.
    E1 RESULT: the hy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
2026-10-05 Find the real Case 9 defect: the intent mean was never propagated
    Case 9 was diagnosed as the intent sub-model being order-deficient, and the
    proposed fix was constant-acceleration (13 -> 15 states). Testing that first
    turned up a simpler cause.
    rcflex_intent_ekf_step set xpred=x and then rotated only the oscillator
    quadratures, so the intent ANGLE was never advanced by dt*thetadot -- while
    F(thx,thdx)=dt advanced the covariance as though it had been. The mean ran a
    constant-POSITION model while the covariance ran constant-VELOCITY. The intent
    states could not track, and because corr(th_ix,a1x) = -0.99 the only available
    sink for the shortfall was the tremor oscillator, which inflated to 2.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
2026-10-05 Fuse sEMG with the IMU as an intent-authority gate on the EKF (E2); it works
    E1 (sEMG -> omega) was negative: omega was never the binding constraint. The
    omega-capture experiment showed the real residual failure is INTENT ABSORPTION
    -- the {omega,2*omega} basis cannot represent off-harmonic tremor, so the
    near-constant-velocity intent states take it instead and pass it to the
    reference as voluntary motion. No IMU statistic detects this: NIS stays tiny
    because intent+tremor still reconstruct the measurement.
    A ceiling experiment (run_intent_authority_experiment, no sEMG anywhere) shows
    q_intent is the right knob and that no fixed value of it works:
    q x1 -> x1/64 mixed 87.99 -> 93.00 %,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
2026-10-05 Record the E2 evidence: benchmark, experiments, calibration and report figures
    Regenerated results for the six-arm sweep and the experiments behind it. Every
    number here is reproducible from the scripts committed in the previous change.
    control_benchmark.csv 120 rows, 6 arms x 20 cases, identical seeds
    control_benchmark_summary.csv one row per arm; three means reported together
    so the hardware-envelope exclusion is visible
    rather than silent
    intent_authority_ceiling.csv the IMU-only q_intent sweep that motivates the
    gate and bounds what it can achieve
    semg_intent_calibratio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
2026-10-05 Add progress report V3: sEMG+IMU fusion and the final benchmark
    Written for the same audience as V2 -- a plain-language status note, with the
    maths left in docs/SEMG_INTENT_FUSION.md.
    Closes five of V2's seven pending items: the EKF-vs-PID decision (now yes, with
    sEMG), the hardware-envelope scoring rule (decided and implemented in code), the
    single-frequency limitation (answered by a sensor, not more oscillators), sEMG
    fusion itself, and the side-by-side comparison. Two remain open and are named as
    such: the inoperative joint-travel check, and the three real-data sEMG checks
    that no public dataset can answer.
    Section 7 is the part that matters for judging the work: it reports a failure we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
2026-10-05 Extend control/sEMG code, add real-tremor and fast-movement experiments, tests
    Merge src/viz into src/visualization; untrack machine-specific .mcp.json
    (kept as .mcp.json.example) and regenerable per-case benchmark traces.
